Kazxd/3dof-sorter/cad/preview/adapter_bolt.png

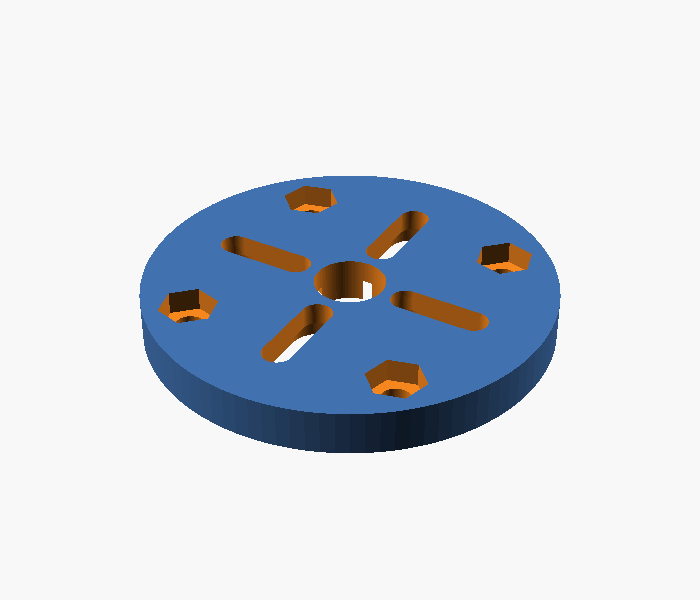
cad/preview/adapter_bolt.png
