Kazxd/3dof-sorter/cad/preview/carrier.png

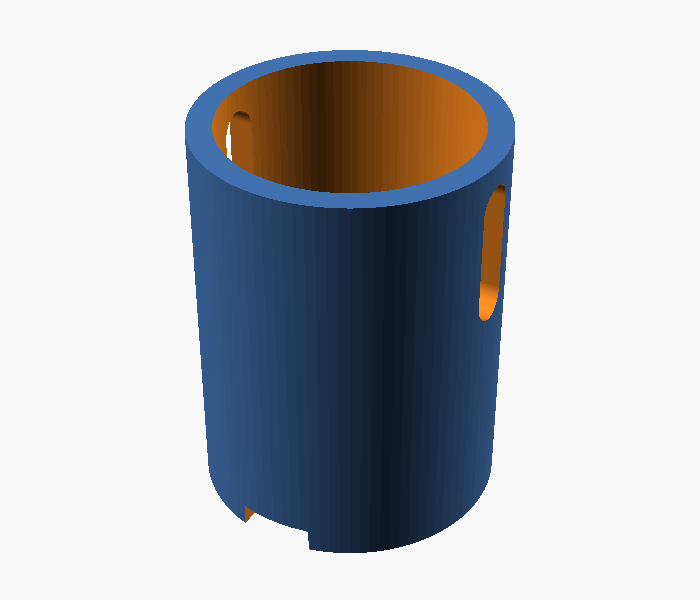
cad/preview/carrier.png
