Kazxd/3dof-sorter/cad/preview/hanger_front.png

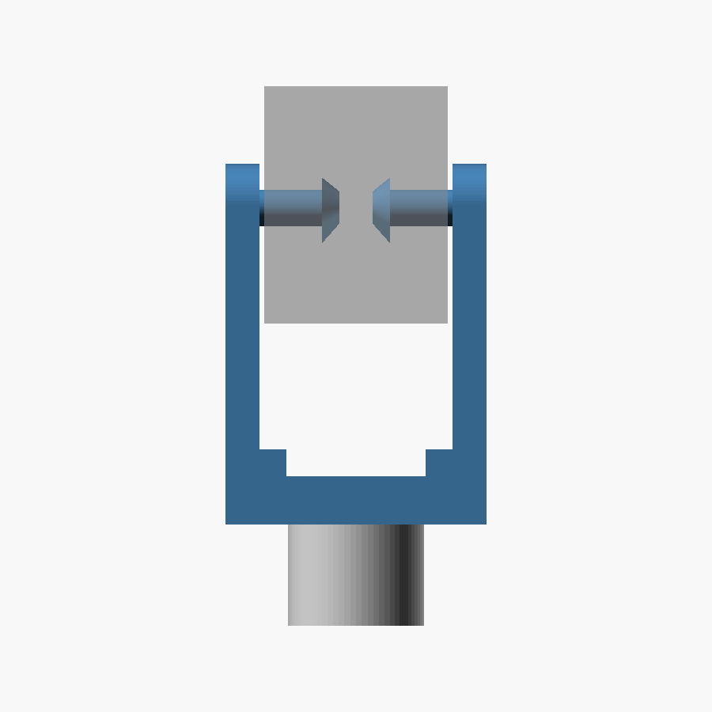
cad/preview/hanger_front.png
