Kazxd/3dof-sorter/cad/preview/rigid_cup.png

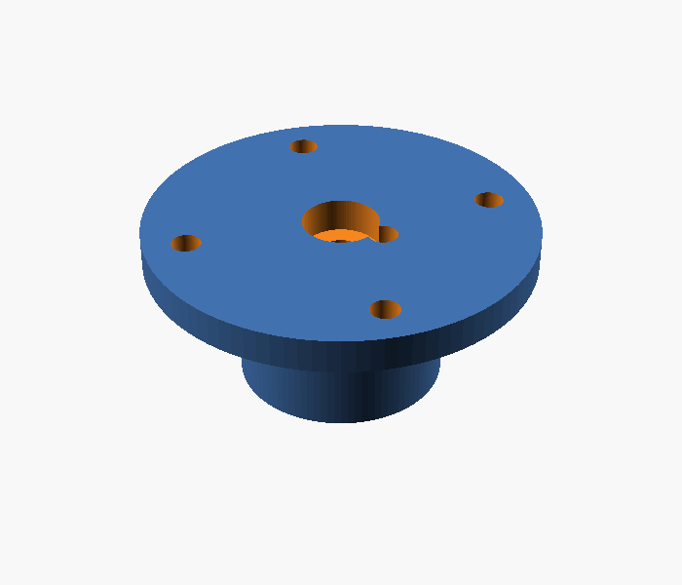
cad/preview/rigid_cup.png
