Kazxd/3dof-sorter/cad/preview/sleeve.png

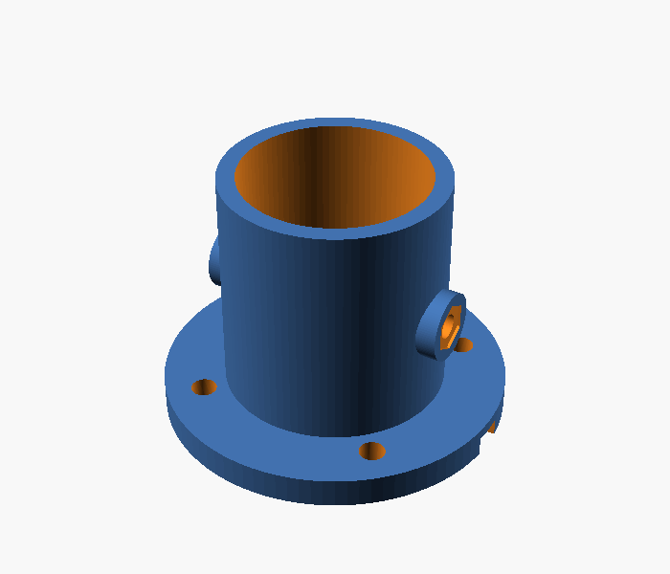
cad/preview/sleeve.png
