Kazxd/3dof-sorter/Nuts and Bolts.v1i.yolov8/valid/images/1-heavy-hex-bolt-6-set-hardware-original-imagfbzp4ufacajw_jpeg_jpg.rf.dfc6f21525f2c15a8e8666800c9e3701.jpg

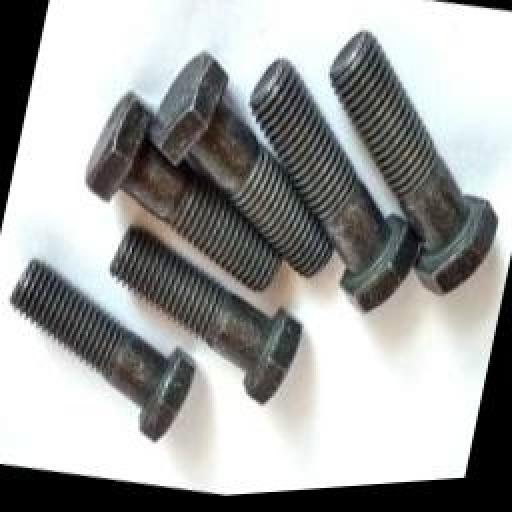
Nuts and Bolts.v1i.yolov8/valid/images/1-heavy-hex-bolt-6-set-hardware-original-imagfbzp4ufacajw_jpeg_jpg.rf.dfc6f21525f2c15a8e8666800c9e3701.jpg
