Kazxd/3dof-sorter/Nuts and Bolts.v1i.yolov8/valid/images/5inch-mild-steel-nut-bolt-500x500_jpeg_jpg.rf.86e7fe1448f5a15573644239efd2a761.jpg

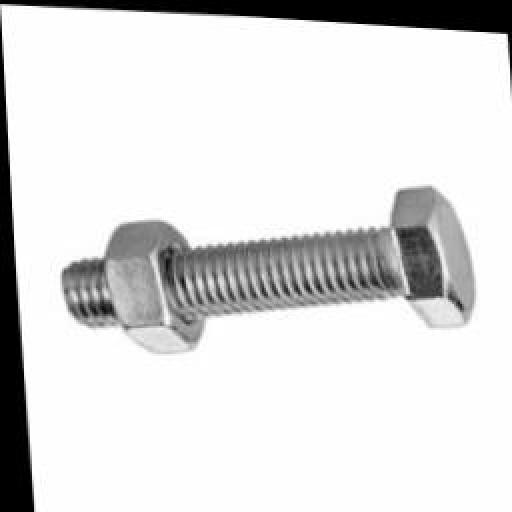
Nuts and Bolts.v1i.yolov8/valid/images/5inch-mild-steel-nut-bolt-500x500_jpeg_jpg.rf.86e7fe1448f5a15573644239efd2a761.jpg
