Kazxd/3dof-sorter/Nuts and Bolts.v1i.yolov8/valid/images/22_jpg.rf.d1f2ec3deb03ffdd9a8e1cb189490dce.jpg

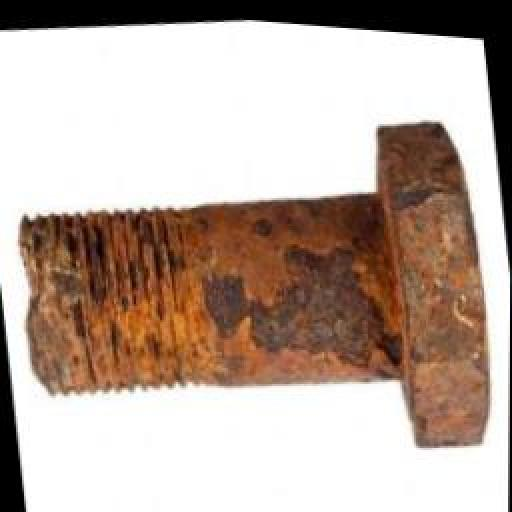
Nuts and Bolts.v1i.yolov8/valid/images/22_jpg.rf.d1f2ec3deb03ffdd9a8e1cb189490dce.jpg
