Kazxd/3dof-sorter/Nuts and Bolts.v1i.yolov8/valid/images/24_jpg.rf.6460cae588378a65f7cb0c4df6d592ca.jpg

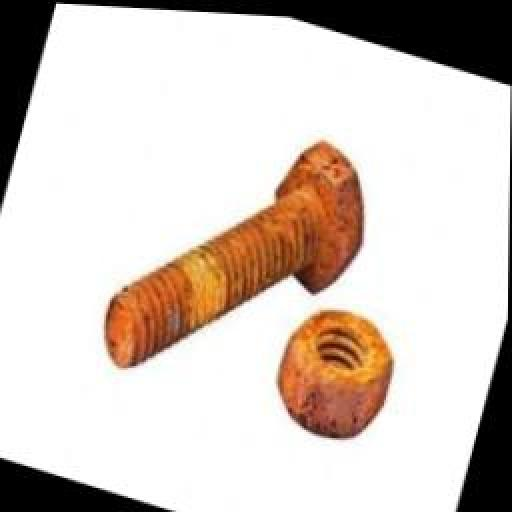
Nuts and Bolts.v1i.yolov8/valid/images/24_jpg.rf.6460cae588378a65f7cb0c4df6d592ca.jpg
