Kazxd/3dof-sorter/Nuts and Bolts.v1i.yolov8/valid/images/27_jpg.rf.afc388b61799de5133c476738ec6b074.jpg

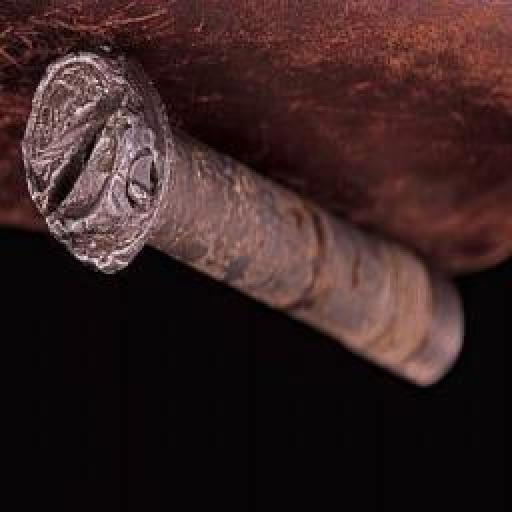
Nuts and Bolts.v1i.yolov8/valid/images/27_jpg.rf.afc388b61799de5133c476738ec6b074.jpg
