Kazxd/3dof-sorter/Nuts and Bolts.v1i.yolov8/valid/images/28_jpg.rf.2d5adec151693ffee0fa9186a34a14be.jpg

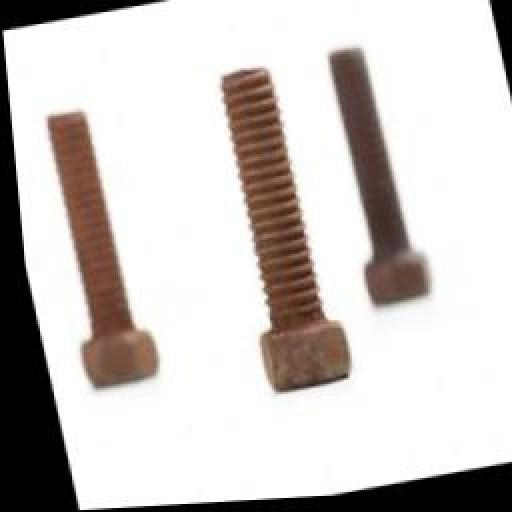
Nuts and Bolts.v1i.yolov8/valid/images/28_jpg.rf.2d5adec151693ffee0fa9186a34a14be.jpg
