Kazxd/3dof-sorter/Nuts and Bolts.v1i.yolov8/valid/images/29_jpg.rf.64ed55d56bdb5906e46a98ffbae678ac.jpg

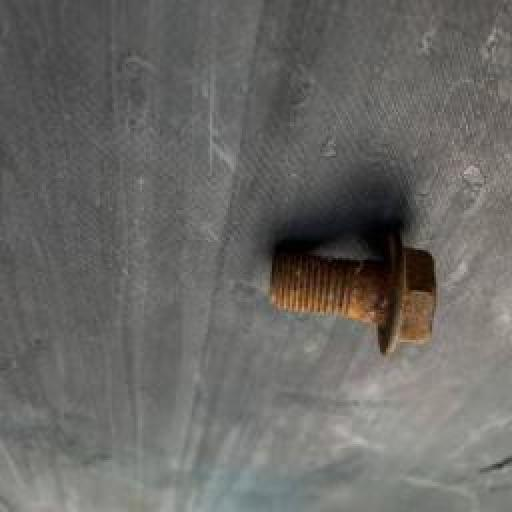
Nuts and Bolts.v1i.yolov8/valid/images/29_jpg.rf.64ed55d56bdb5906e46a98ffbae678ac.jpg
