Kazxd/3dof-sorter/Nuts and Bolts.v1i.yolov8/valid/images/30_jpg.rf.de850487259090f0898810ef57d4c8f7.jpg

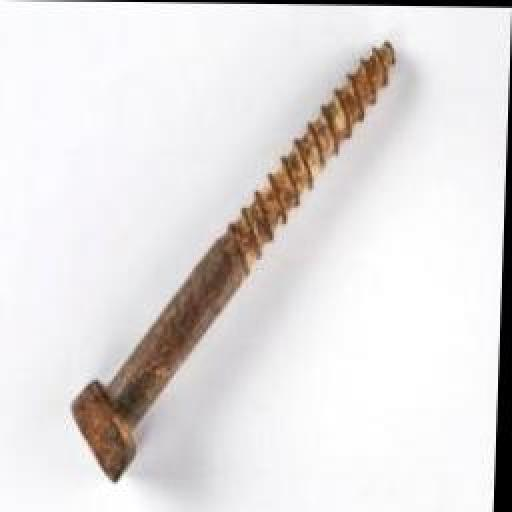
Nuts and Bolts.v1i.yolov8/valid/images/30_jpg.rf.de850487259090f0898810ef57d4c8f7.jpg
