Kazxd/3dof-sorter/Nuts and Bolts.v1i.yolov8/valid/images/30_jpg.rf.e808f95cd140b9b9f8c46c7ac13455a9.jpg

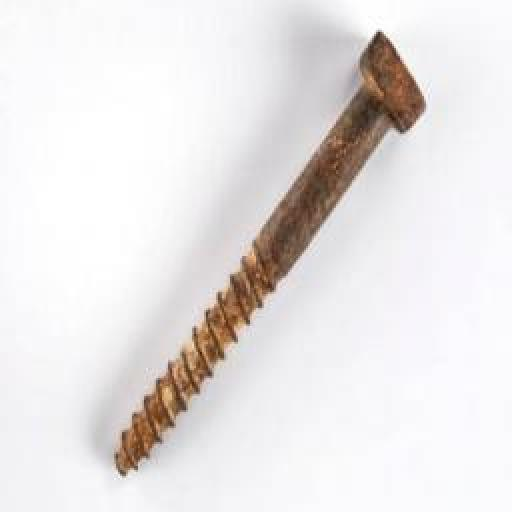
Nuts and Bolts.v1i.yolov8/valid/images/30_jpg.rf.e808f95cd140b9b9f8c46c7ac13455a9.jpg
