Kazxd/3dof-sorter/Nuts and Bolts.v1i.yolov8/valid/images/50_jpg.rf.1675c04a91fb54c2cea84c65e0de0e85.jpg

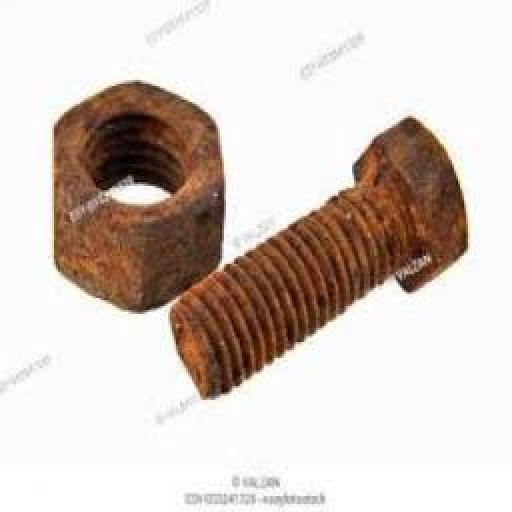
Nuts and Bolts.v1i.yolov8/valid/images/50_jpg.rf.1675c04a91fb54c2cea84c65e0de0e85.jpg
