Kazxd/3dof-sorter/Nuts and Bolts.v1i.yolov8/valid/images/53_jpg.rf.82dfdd458fb2ca40ef70635bc36b0871.jpg

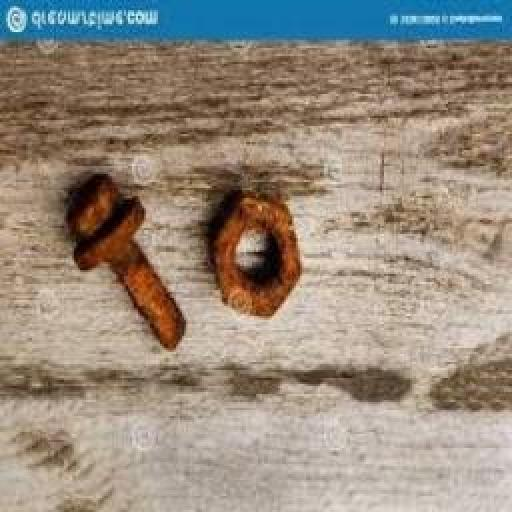
Nuts and Bolts.v1i.yolov8/valid/images/53_jpg.rf.82dfdd458fb2ca40ef70635bc36b0871.jpg
