Kazxd/3dof-sorter/Nuts and Bolts.v1i.yolov8/valid/images/360_F_650699123_XyNEPfjZqgRsTFS0PMfwW5s5IRTDETz2_jpg.rf.19e3b7fa537eb292dc3e8215b2b9476f.jpg

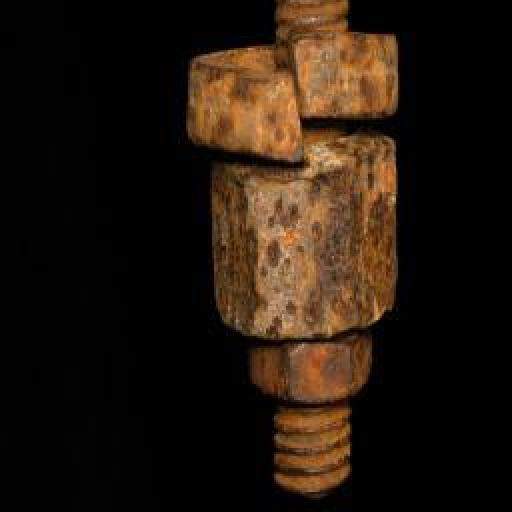
Nuts and Bolts.v1i.yolov8/valid/images/360_F_650699123_XyNEPfjZqgRsTFS0PMfwW5s5IRTDETz2_jpg.rf.19e3b7fa537eb292dc3e8215b2b9476f.jpg
