Kazxd/3dof-sorter/Nuts and Bolts.v1i.yolov8/valid/images/545f23911fa3bb2c8df4edf4684a21a9_jpg.rf.d1d3743f2dee5c5640503f124749c4a2.jpg

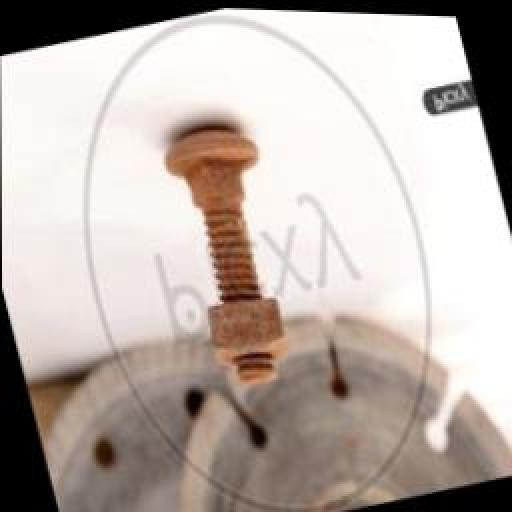
Nuts and Bolts.v1i.yolov8/valid/images/545f23911fa3bb2c8df4edf4684a21a9_jpg.rf.d1d3743f2dee5c5640503f124749c4a2.jpg
