Kazxd/3dof-sorter/Nuts and Bolts.v1i.yolov8/valid/images/6491-a-bolt-and-nut-isolated-on-a-white-background-pv_jpg.rf.5d7b3faf881b47f7fb27427807b29e08.jpg

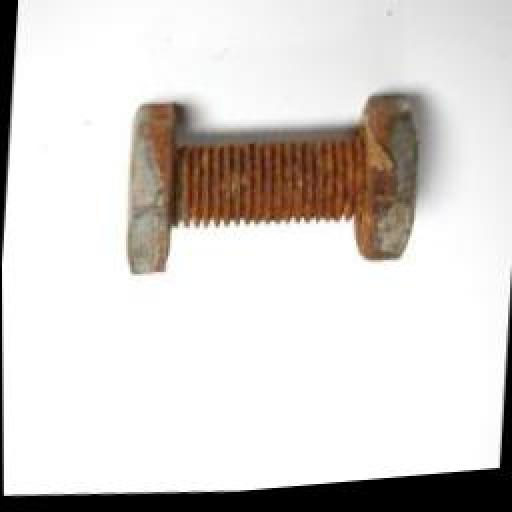
Nuts and Bolts.v1i.yolov8/valid/images/6491-a-bolt-and-nut-isolated-on-a-white-background-pv_jpg.rf.5d7b3faf881b47f7fb27427807b29e08.jpg
