Kazxd/3dof-sorter/Nuts and Bolts.v1i.yolov8/valid/images/9703160-rusty-screws-and-bolts-isolated-on-white_jpg.rf.10e5fe2db2fa7fae86ca0d51dbcad605.jpg

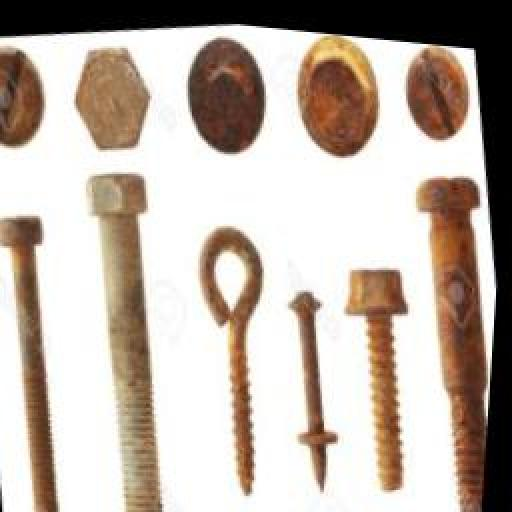
Nuts and Bolts.v1i.yolov8/valid/images/9703160-rusty-screws-and-bolts-isolated-on-white_jpg.rf.10e5fe2db2fa7fae86ca0d51dbcad605.jpg
