Kazxd/3dof-sorter/Nuts and Bolts.v1i.yolov8/valid/images/409269715_jpg.rf.56d3913b8d70f14f4a9e99a2cb2239ff.jpg

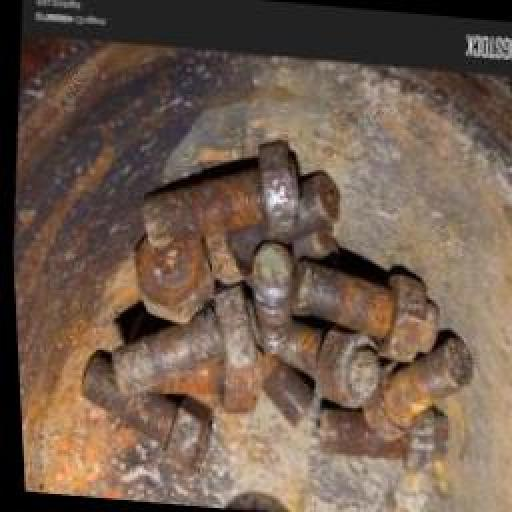
Nuts and Bolts.v1i.yolov8/valid/images/409269715_jpg.rf.56d3913b8d70f14f4a9e99a2cb2239ff.jpg
