Kazxd/3dof-sorter/Nuts and Bolts.v1i.yolov8/valid/images/-been-snipped-or-broken-from-its-head-isolated-on-a-white-background-2PN02R0_jpg.rf.fc58b6a8a093d53d864c8f45f3969fa1.jpg

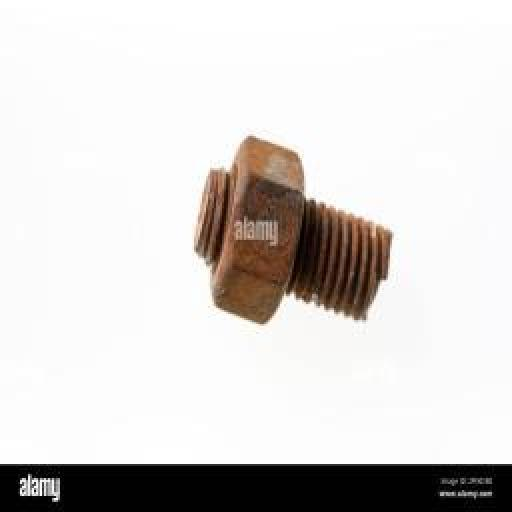
Nuts and Bolts.v1i.yolov8/valid/images/-been-snipped-or-broken-from-its-head-isolated-on-a-white-background-2PN02R0_jpg.rf.fc58b6a8a093d53d864c8f45f3969fa1.jpg
