Kazxd/3dof-sorter/Nuts and Bolts.v1i.yolov8/valid/images/ent-white-background-heavy-metal-bolt-nuts-washers-tools-equipment-144955972_jpg.rf.b583a54da3a61eebf552d2887a8948e6.jpg

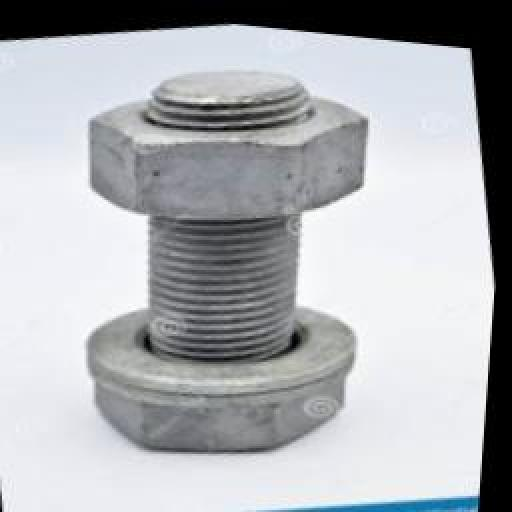
Nuts and Bolts.v1i.yolov8/valid/images/ent-white-background-heavy-metal-bolt-nuts-washers-tools-equipment-144955972_jpg.rf.b583a54da3a61eebf552d2887a8948e6.jpg
