Kazxd/3dof-sorter/Nuts and Bolts.v1i.yolov8/valid/images/FIB1R56IDIN7K44_jpg.rf.6c4e473989d37a4cc9a64add21283fd1.jpg

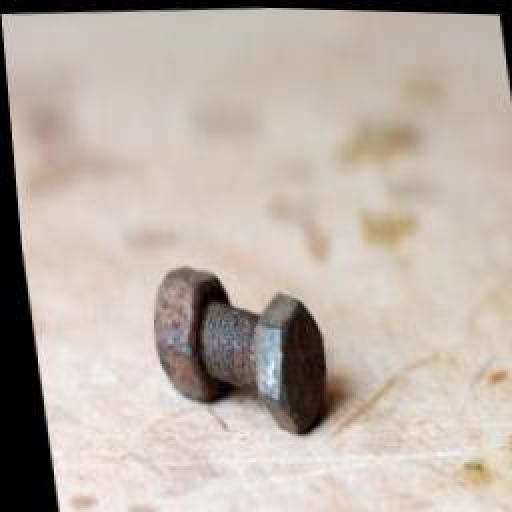
Nuts and Bolts.v1i.yolov8/valid/images/FIB1R56IDIN7K44_jpg.rf.6c4e473989d37a4cc9a64add21283fd1.jpg
