Kazxd/3dof-sorter/Nuts and Bolts.v1i.yolov8/valid/images/image_116_png_jpg.rf.806f9b7ccc918074ac511350cd38e6d4.jpg

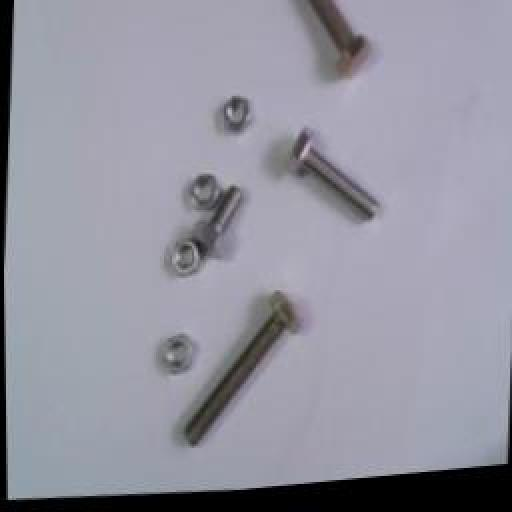
Nuts and Bolts.v1i.yolov8/valid/images/image_116_png_jpg.rf.806f9b7ccc918074ac511350cd38e6d4.jpg
