Kazxd/3dof-sorter/Nuts and Bolts.v1i.yolov8/valid/images/image_124_png_jpg.rf.222f5cac51b2965d7b71004286ff9e4e.jpg

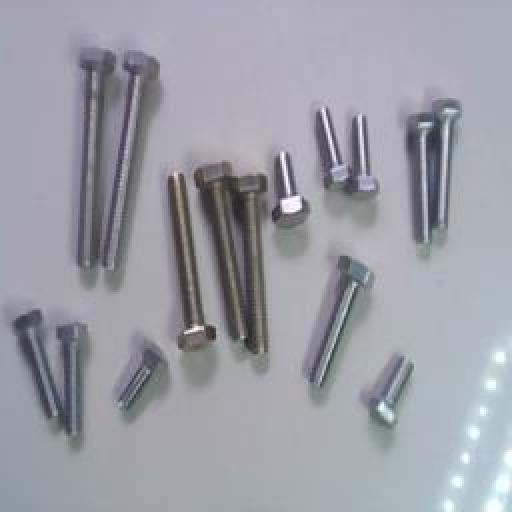
Nuts and Bolts.v1i.yolov8/valid/images/image_124_png_jpg.rf.222f5cac51b2965d7b71004286ff9e4e.jpg
