Kazxd/3dof-sorter/Nuts and Bolts.v1i.yolov8/valid/images/image_127_png_jpg.rf.f189bd708a3b0e386e8cdf17f5f00c28.jpg

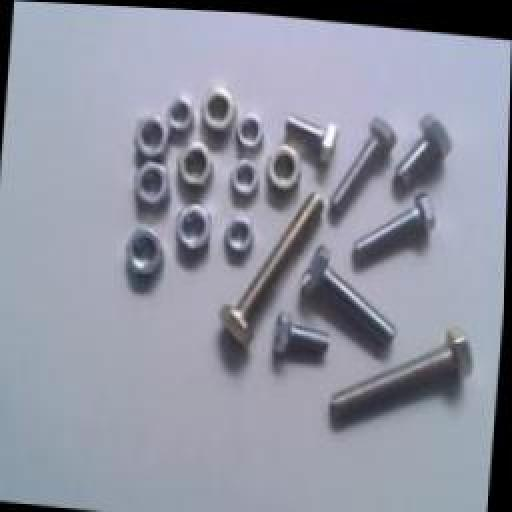
Nuts and Bolts.v1i.yolov8/valid/images/image_127_png_jpg.rf.f189bd708a3b0e386e8cdf17f5f00c28.jpg
