Kazxd/3dof-sorter/Nuts and Bolts.v1i.yolov8/valid/images/image_140_png_jpg.rf.bd3fe15dc6e5364fa3a23be50c95cafd.jpg

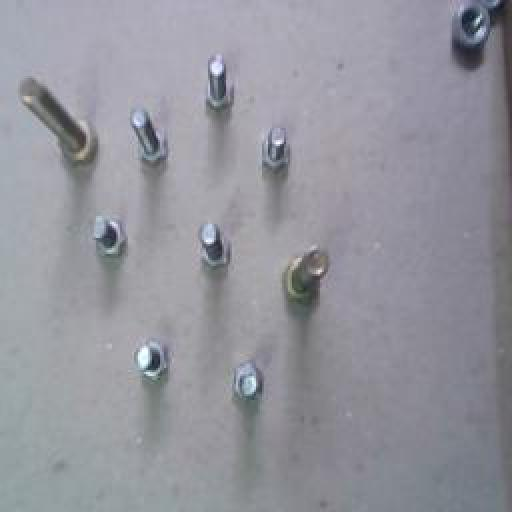
Nuts and Bolts.v1i.yolov8/valid/images/image_140_png_jpg.rf.bd3fe15dc6e5364fa3a23be50c95cafd.jpg
