Kazxd/3dof-sorter/Nuts and Bolts.v1i.yolov8/valid/images/image_160_png_jpg.rf.7491435820400c92e7f343dc29fcd595.jpg

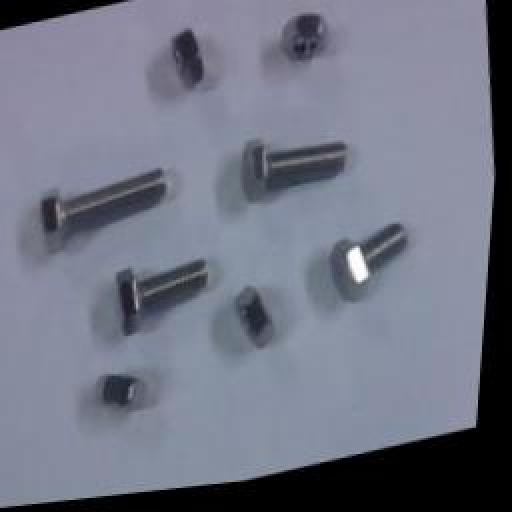
Nuts and Bolts.v1i.yolov8/valid/images/image_160_png_jpg.rf.7491435820400c92e7f343dc29fcd595.jpg
