Kazxd/3dof-sorter/Nuts and Bolts.v1i.yolov8/valid/images/image_160_png_jpg.rf.e400411dc05c77701b53554323aa39fd.jpg

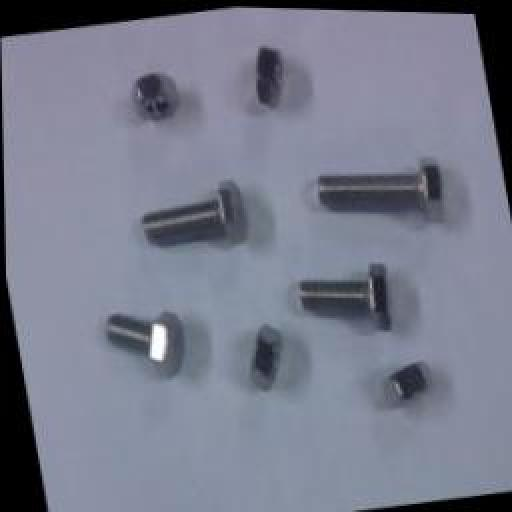
Nuts and Bolts.v1i.yolov8/valid/images/image_160_png_jpg.rf.e400411dc05c77701b53554323aa39fd.jpg
