Kazxd/3dof-sorter/Nuts and Bolts.v1i.yolov8/valid/images/images10_jpg.rf.aa0c122afe898b3eaac940de06f8ee19.jpg

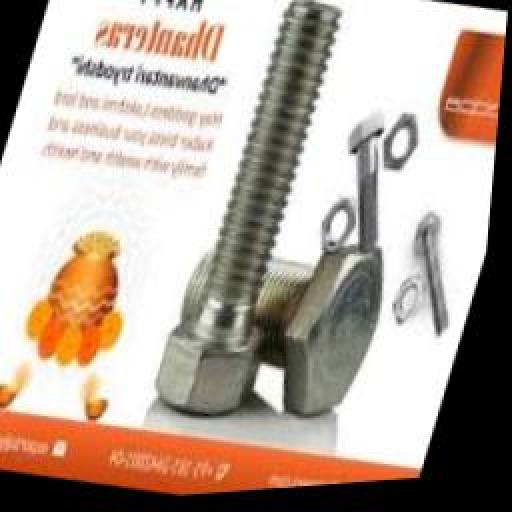
Nuts and Bolts.v1i.yolov8/valid/images/images10_jpg.rf.aa0c122afe898b3eaac940de06f8ee19.jpg
