Kazxd/3dof-sorter/Nuts and Bolts.v1i.yolov8/valid/images/images102_jpg.rf.8625699c36f615650583026785455182.jpg

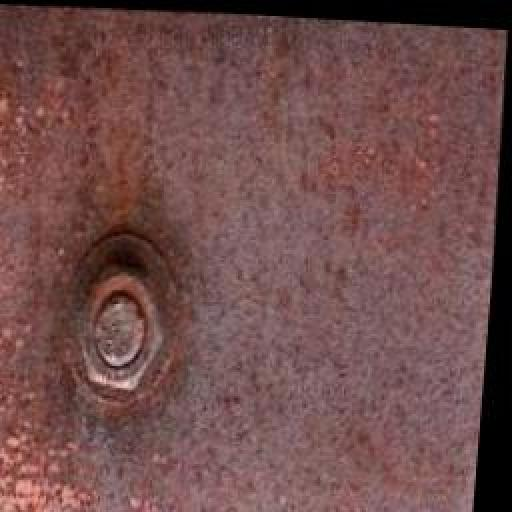
Nuts and Bolts.v1i.yolov8/valid/images/images102_jpg.rf.8625699c36f615650583026785455182.jpg
