Kazxd/3dof-sorter/Nuts and Bolts.v1i.yolov8/valid/images/images130_jpg.rf.2f850fdbcc7ca3f3bb6750351661165f.jpg

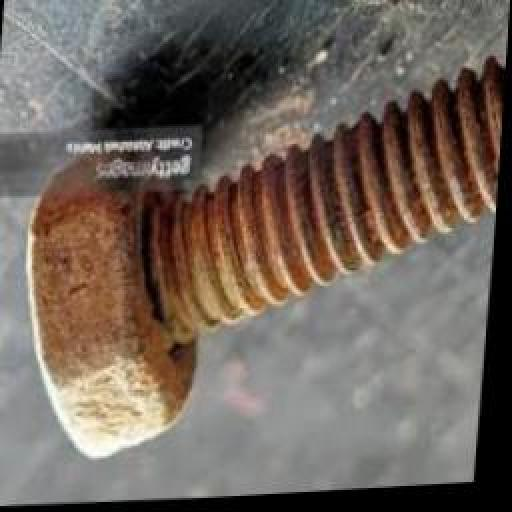
Nuts and Bolts.v1i.yolov8/valid/images/images130_jpg.rf.2f850fdbcc7ca3f3bb6750351661165f.jpg
