Kazxd/3dof-sorter/Nuts and Bolts.v1i.yolov8/valid/images/images133_jpg.rf.38856a5a66fccfa05bb6818912eb8c8f.jpg

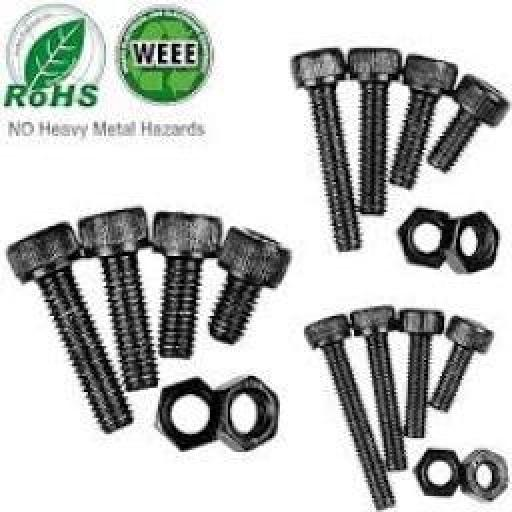
Nuts and Bolts.v1i.yolov8/valid/images/images133_jpg.rf.38856a5a66fccfa05bb6818912eb8c8f.jpg
