Kazxd/3dof-sorter/Nuts and Bolts.v1i.yolov8/valid/images/rusty-bolt-and-nuts-2C5777T_jpg.rf.48c1cb1803eae311d1a35a7afa7476f2.jpg

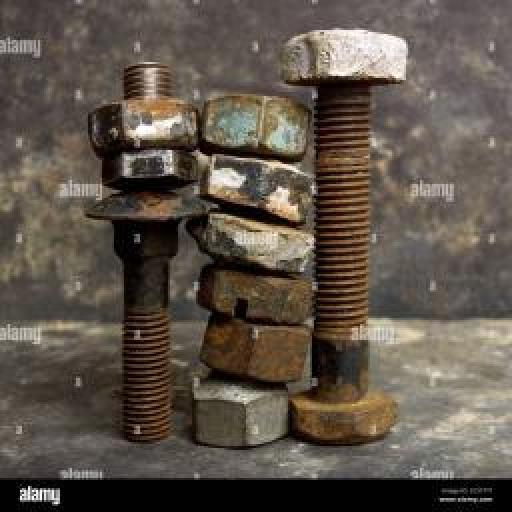
Nuts and Bolts.v1i.yolov8/valid/images/rusty-bolt-and-nuts-2C5777T_jpg.rf.48c1cb1803eae311d1a35a7afa7476f2.jpg
