Kazxd/3dof-sorter/Nuts and Bolts.v1i.yolov8/valid/images/rusty-bolt-royalty-free-image-1636050220_jpg.rf.3dac28fb71df53db622fbdd1d7d432d8.jpg

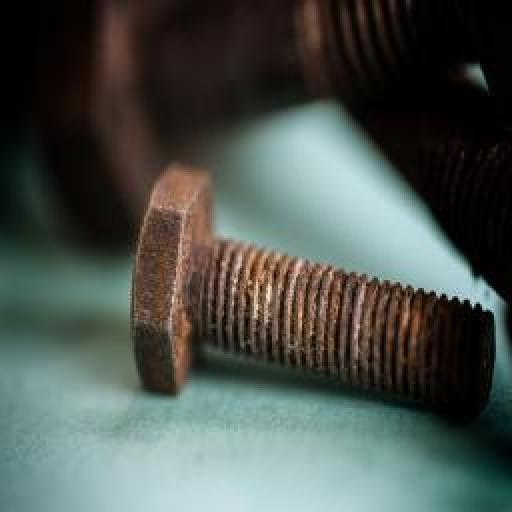
Nuts and Bolts.v1i.yolov8/valid/images/rusty-bolt-royalty-free-image-1636050220_jpg.rf.3dac28fb71df53db622fbdd1d7d432d8.jpg
