Kazxd/3dof-sorter/Nuts and Bolts.v1i.yolov8/valid/images/rusty-bolts-with-nuts-white-background_525574-5550_jpg.rf.06d85822295db872927e3f74d5d160ce.jpg

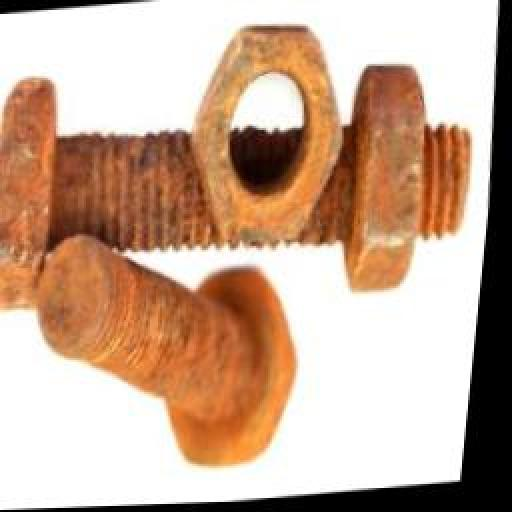
Nuts and Bolts.v1i.yolov8/valid/images/rusty-bolts-with-nuts-white-background_525574-5550_jpg.rf.06d85822295db872927e3f74d5d160ce.jpg
