Kazxd/3dof-sorter/Nuts and Bolts.v1i.yolov8/valid/images/rusty-bolts_jpg.rf.68e16ab453f6119d23ae1e8f16882ad3.jpg

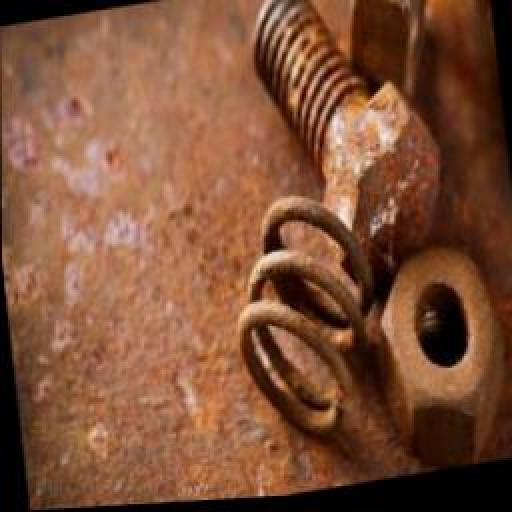
Nuts and Bolts.v1i.yolov8/valid/images/rusty-bolts_jpg.rf.68e16ab453f6119d23ae1e8f16882ad3.jpg
