Kazxd/3dof-sorter/Nuts and Bolts.v1i.yolov8/valid/images/rusty-nut-bolt-isolated-on-260nw-70090501_jpg.rf.6edbee4fa5cebb4eb70144c56de7757c.jpg

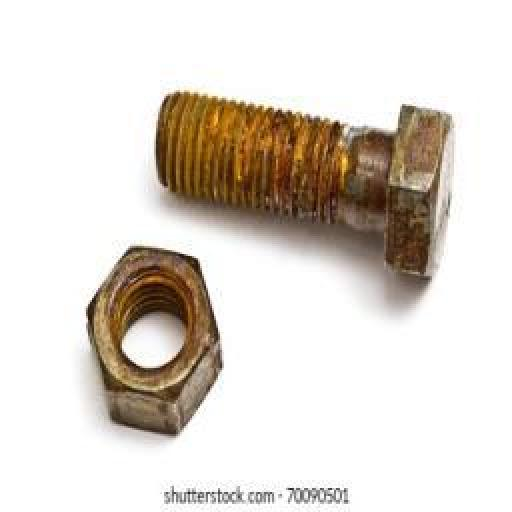
Nuts and Bolts.v1i.yolov8/valid/images/rusty-nut-bolt-isolated-on-260nw-70090501_jpg.rf.6edbee4fa5cebb4eb70144c56de7757c.jpg
