Kazxd/3dof-sorter/Nuts and Bolts.v1i.yolov8/valid/images/rusty-nut-bolt-isolated-white-28397746_jpg.rf.41d1f0284ed0980c21c48107f2b0d2d7.jpg

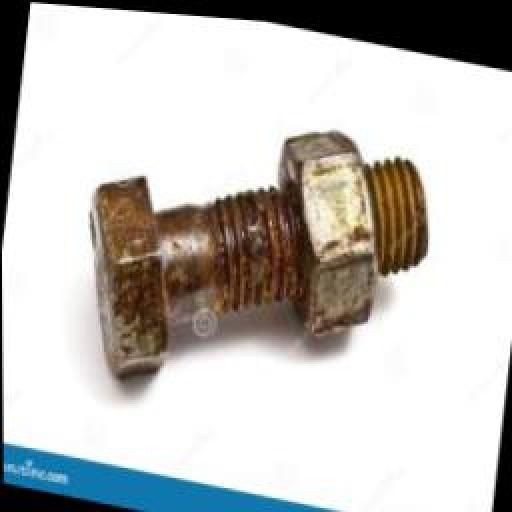
Nuts and Bolts.v1i.yolov8/valid/images/rusty-nut-bolt-isolated-white-28397746_jpg.rf.41d1f0284ed0980c21c48107f2b0d2d7.jpg
