Kazxd/3dof-sorter/Nuts and Bolts.v1i.yolov8/valid/images/screwed-royalty-free-image-1638481300_jpg.rf.7db511b03831097691b17ad6a8ffaa8f.jpg

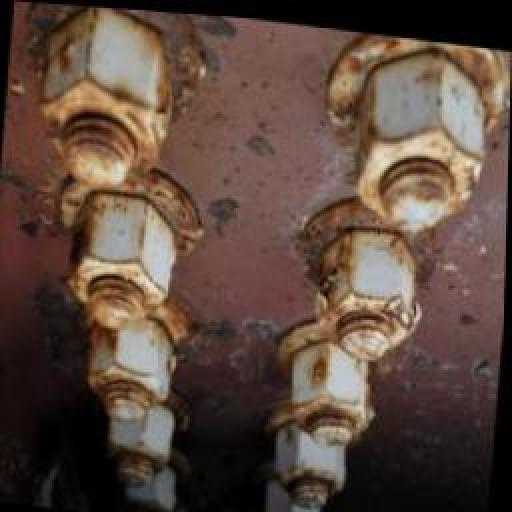
Nuts and Bolts.v1i.yolov8/valid/images/screwed-royalty-free-image-1638481300_jpg.rf.7db511b03831097691b17ad6a8ffaa8f.jpg
