Kazxd/3dof-sorter/Nuts and Bolts.v1i.yolov8/valid/images/screws_034_png_jpg.rf.e1b1466a737b8fe22fa448a830b26b05.jpg

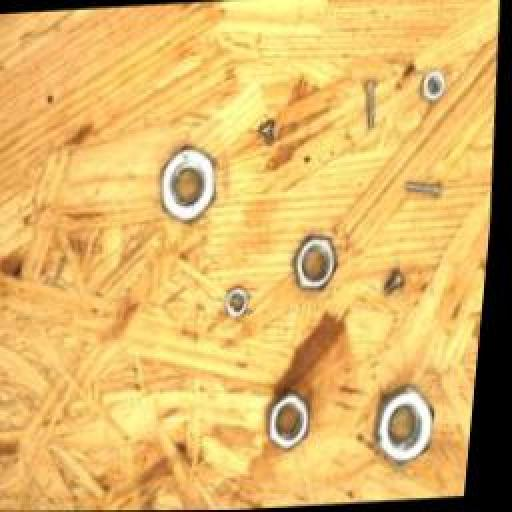
Nuts and Bolts.v1i.yolov8/valid/images/screws_034_png_jpg.rf.e1b1466a737b8fe22fa448a830b26b05.jpg
