Kazxd/3dof-sorter/Nuts and Bolts.v1i.yolov8/valid/images/steel-bolt-hex-nut-washer-260nw-2484265203_jpg.rf.426e1dbc908650547e6eae5a579fb2f9.jpg

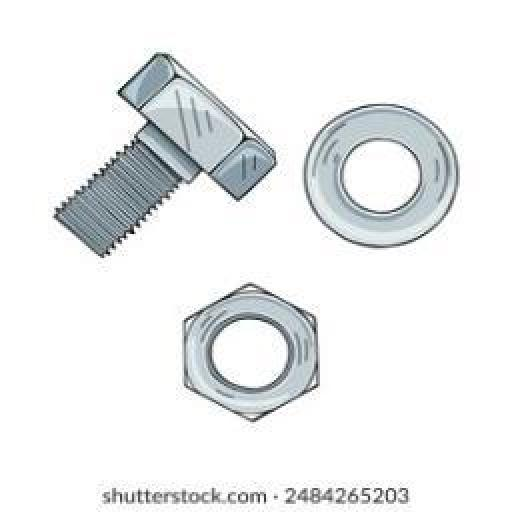
Nuts and Bolts.v1i.yolov8/valid/images/steel-bolt-hex-nut-washer-260nw-2484265203_jpg.rf.426e1dbc908650547e6eae5a579fb2f9.jpg
