Kazxd/3dof-sorter/Nuts and Bolts.v1i.yolov8/valid/images/thumb-16-_jpg.rf.abbc0b00ce17790db569c43730c551b1.jpg

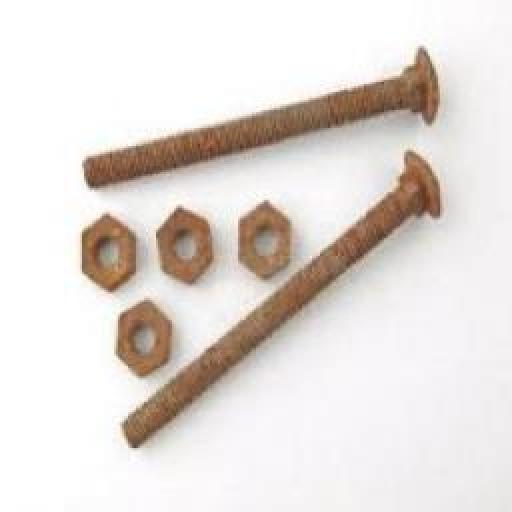
Nuts and Bolts.v1i.yolov8/valid/images/thumb-16-_jpg.rf.abbc0b00ce17790db569c43730c551b1.jpg
