Kazxd/3dof-sorter/Nuts and Bolts.v1i.yolov8/valid/images/thumb-33-_jpg.rf.a28ae6f798aafaa6da089a47b7dafef5.jpg

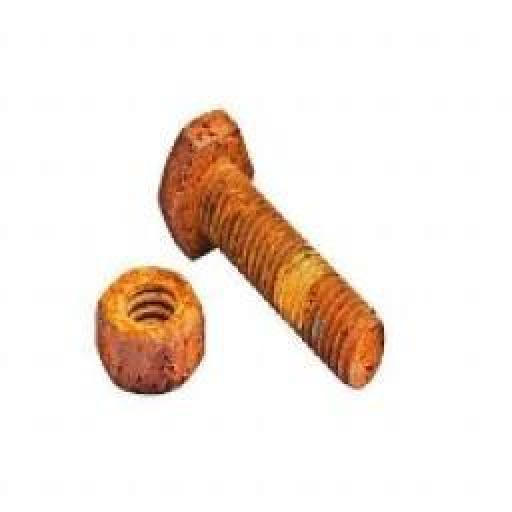
Nuts and Bolts.v1i.yolov8/valid/images/thumb-33-_jpg.rf.a28ae6f798aafaa6da089a47b7dafef5.jpg
