Kazxd/3dof-sorter/Nuts and Bolts.v1i.yolov8/valid/images/thumb-43-_jpg.rf.0d8759c0bf81b6b5e54e2ecef139d906.jpg

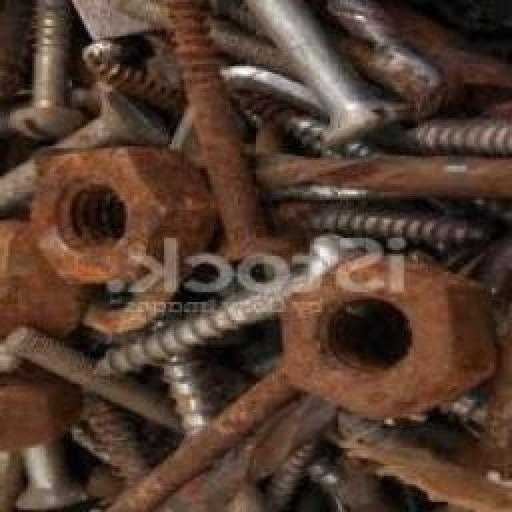
Nuts and Bolts.v1i.yolov8/valid/images/thumb-43-_jpg.rf.0d8759c0bf81b6b5e54e2ecef139d906.jpg
