Kazxd/3dof-sorter/Nuts and Bolts.v1i.yolov8/valid/images/thumb-45-_jpg.rf.ce1f24acde7183acbda3fc9f8d2d387d.jpg

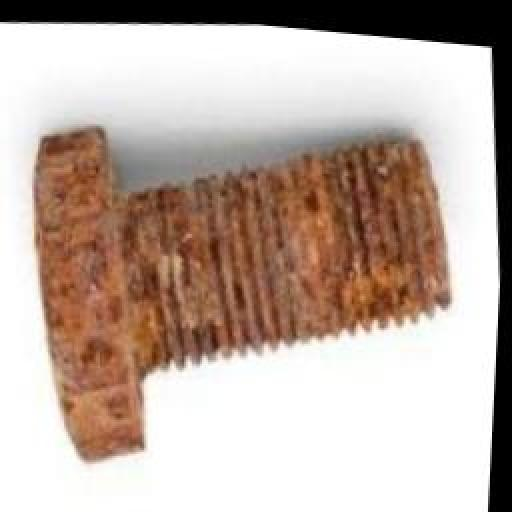
Nuts and Bolts.v1i.yolov8/valid/images/thumb-45-_jpg.rf.ce1f24acde7183acbda3fc9f8d2d387d.jpg
