Kazxd/3dof-sorter/Nuts and Bolts.v1i.yolov8/valid/images/thumb-46-_jpg.rf.b82bc75c01313968185569fc0239f79b.jpg

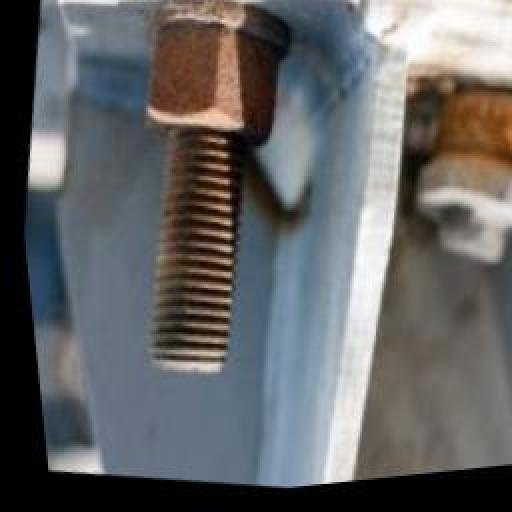
Nuts and Bolts.v1i.yolov8/valid/images/thumb-46-_jpg.rf.b82bc75c01313968185569fc0239f79b.jpg
