Kazxd/3dof-sorter/Nuts and Bolts.v1i.yolov8/valid/images/tvs-bolts-500x500_jpg.rf.d076b9053ce634e65f1fc6d05ca51b9c.jpg

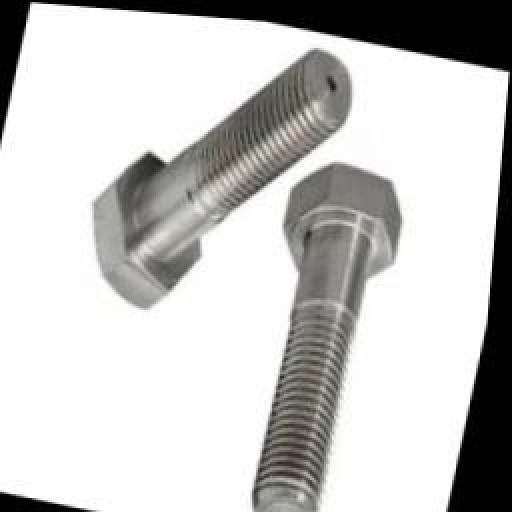
Nuts and Bolts.v1i.yolov8/valid/images/tvs-bolts-500x500_jpg.rf.d076b9053ce634e65f1fc6d05ca51b9c.jpg
