Kazxd/3dof-sorter/Nuts and Bolts.v1i.yolov8/valid/images/white-background-closeup-rusty-nuts-bolts-white-background-closeup-105165246_jpg.rf.6880e69673c644f6f0d9fc2275443cf6.jpg

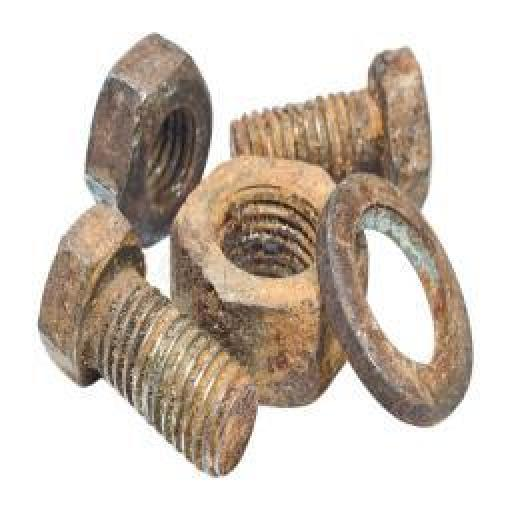
Nuts and Bolts.v1i.yolov8/valid/images/white-background-closeup-rusty-nuts-bolts-white-background-closeup-105165246_jpg.rf.6880e69673c644f6f0d9fc2275443cf6.jpg
