Kazxd/3dof-sorter/cad/stl/magnet_hanger_petg.stl

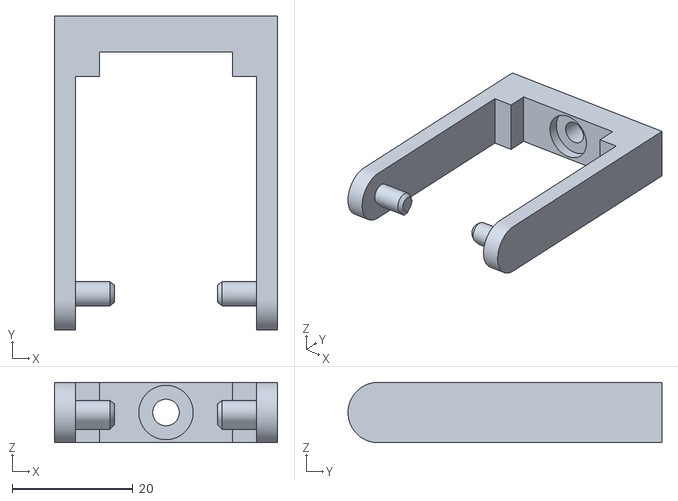
[picture p52: CAD file, 2026-10-26]
cad/stl/magnet_hanger_petg.stl
37.0 x 52.0 x 10.0
