Kazxd/3dof-sorter/cad/stl/magnet_hanger_pla_petg.stl

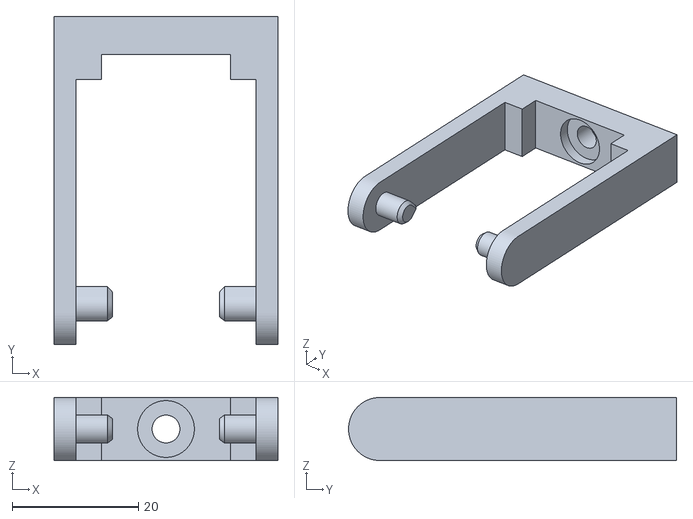
[picture p53: CAD file, 2026-10-26]
cad/stl/magnet_hanger_pla_petg.stl
35.5 x 52.0 x 10.0
