Kazxd/3dof-sorter/cad/stl/magnet_hanger.stl

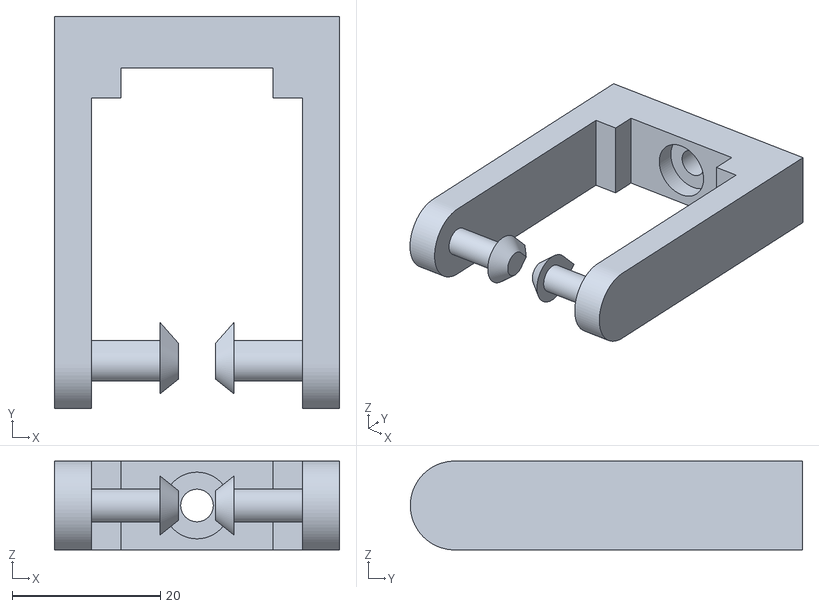
[picture p54: CAD file, 2026-10-26]
cad/stl/magnet_hanger.stl
38.5 x 53.0 x 12.0
