Kazxd/3dof-sorter/cad/stl/magnet_peg_test.stl

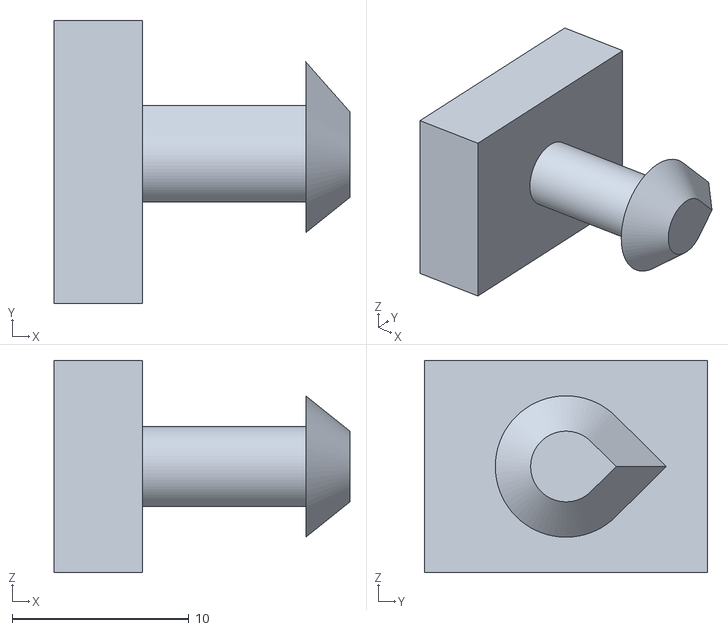
[picture p55: CAD file, 2026-10-26]
cad/stl/magnet_peg_test.stl
16.8 x 16.0 x 12.0
