Kazxd/3dof-sorter/cad/stl/rigid_cup.stl

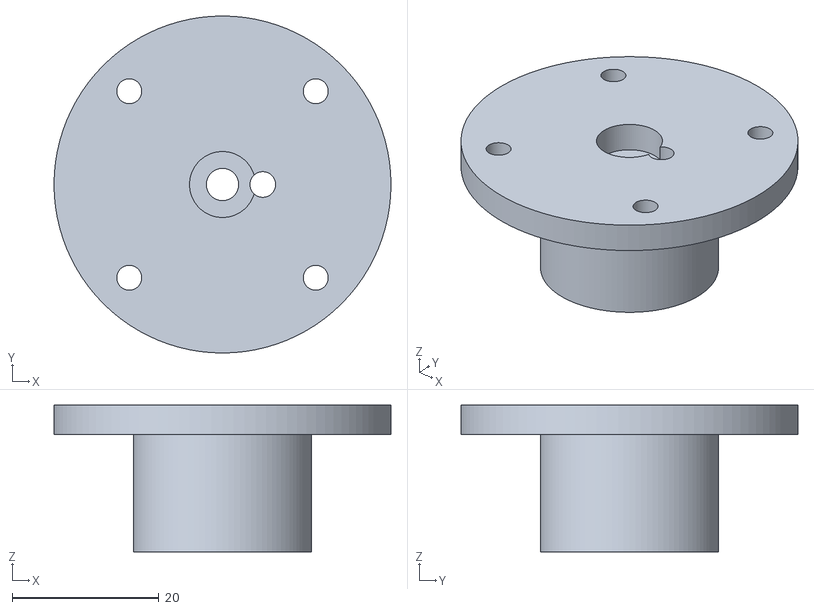
[picture p56: CAD file, 2026-10-20]
cad/stl/rigid_cup.stl
46.0 x 46.0 x 20.0
