Kazxd/3dof-sorter/cad/stl/adapter_horn.stl

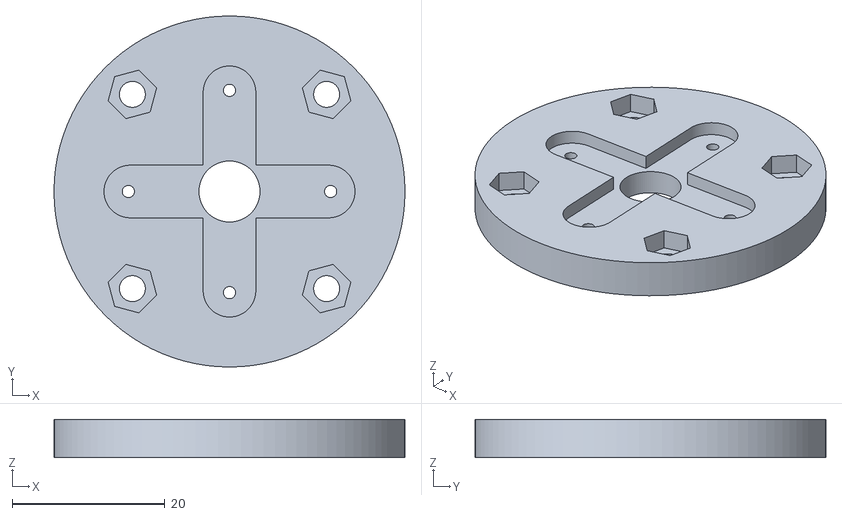
[picture p57: CAD file, 2026-10-20]
cad/stl/adapter_horn.stl
46.0 x 46.0 x 5.00
