Kazxd/3dof-sorter/cad/stl/sleeve.stl

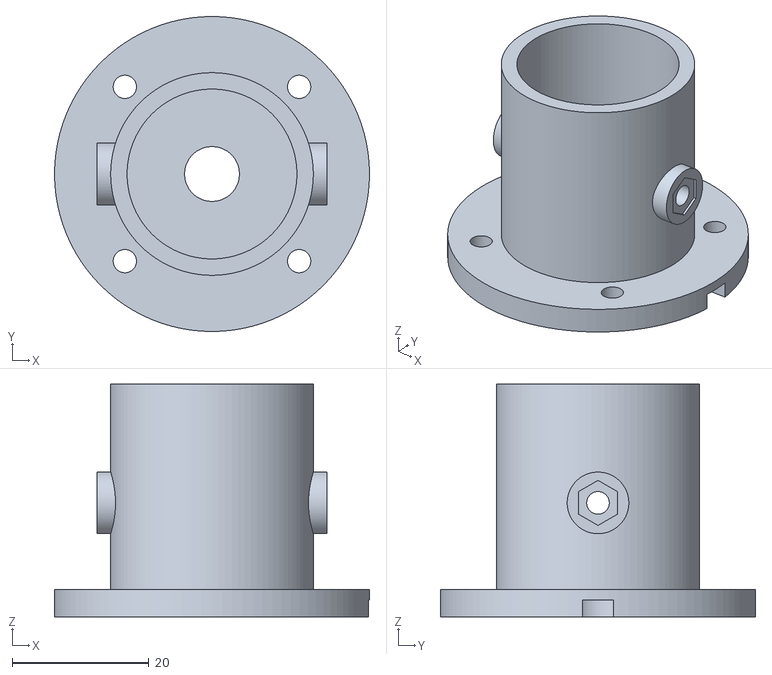
[picture p58: CAD file, 2026-10-20]
cad/stl/sleeve.stl
46.0 x 46.0 x 34.0
