Kazxd/3dof-sorter/cad/stl/carrier.stl

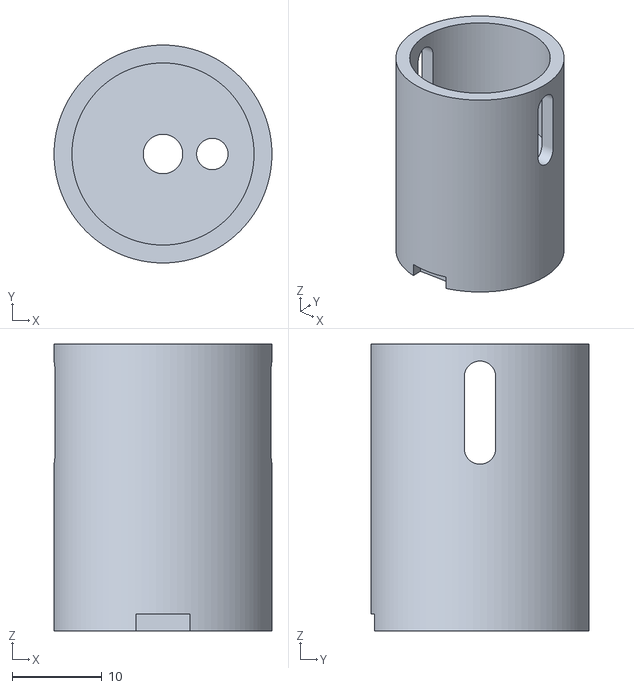
[picture p59: CAD file, 2026-10-20]
cad/stl/carrier.stl
24.3 x 24.3 x 32.0
