Kazxd/3dof-sorter/cad/stl/adapter_bolt.stl

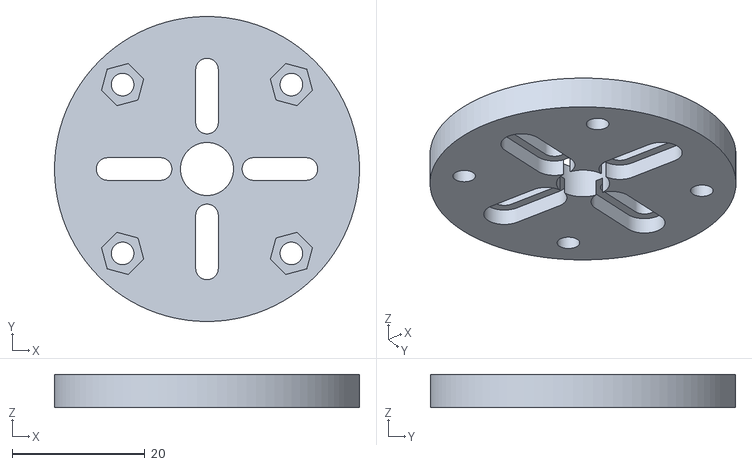
[picture p60: CAD file, 2026-10-20]
cad/stl/adapter_bolt.stl
46.0 x 46.0 x 5.00
