Kazxd/3dof-sorter/cad/magnet_hanger.scad

// magnet_hanger.scad - free-swinging hanger for the KK-P20/15 electromagnet
// =============================================================================
// The arm has no wrist servo, so a magnet bolted to the forearm tilts with it.
// This U-shaped hanger hooks into two Ø6 mm holes drilled across the forearm end
// and swings freely, so gravity keeps the magnet face pointing straight down.
//
//          side view of forearm end              front view (looking along the arm)
//      ______________________                    hook ->|  |<- hook (pegs point inward)
//     |                      |  35               |  |=======|  |
//     |            (o)<-hole |  tall             |  |  arm  |  |   arm end 27 wide
//     |____________^_________|                   |  |=======|  |
//                  17.5 from front, 17.5 up      |  |       |  |
//                                                |  |_______|  |  <- hanger, swings
//                                                |_____[o]_____|  <- screw into magnet
//                                                    [magnet]
//
// Print: TPU (95A), lying flat exactly as exported (no supports). 0.2 mm layers,
// 3 walls, 40 % infill, slow (20-25 mm/s), retraction off or very short.
// Pegs use a teardrop profile so they print without support; the hanger hangs on
// the round top of the peg, so the point never touches the hole.
//
// Fit: TPU is flexible, so just pull one arm outward, push its peg into the hole until
// the barb pops through the wall into the hollow, then do the other side. The barb is
// solid and oversized: TPU squeezes through the hole and springs back open inside.

part = "hanger";      // hanger | peg_test | assembly
style = "tpu";        // tpu = barbed snap pegs | rigid = PLA/PETG, short plain pegs, no barbs
$fn = 72;

// ---- forearm end (measured, ±1-2 mm) -------------------------------------------
arm_width   = 27.0;   // across the arm, side face to side face        [measured]
wall        = 8.0;    // side-wall thickness before the hollow inside  [measured ~7, +1 margin]
hole_d      = 6.0;    // drill size                                    [measured]
pivot_up    = 17.5;   // hole centre above the arm's bottom edge       [measured]
pivot_back  = 17.5;   // hole centre back from the arm's front edge    [measured]

// ---- magnet -------------------------------------------------------------------------
mag_d       = 20.0;
mag_h       = 15.0;
screw_d     = 4.4;    // passes M3 (use a washer) and M4
screw_len   = 10.0;   // the screw you have, total length under the head
screw_floor = 4.0;    // plastic left under the screw head (rest of the bar is recessed)
head_recess_d = 9.0;  // room for the screw head + a small washer

// ---- hanger ------------------------------------------------------------------------
side_gap    = 1.5;    // clearance each side: 30 mm between the arms for a 27 mm forearm (±1-2 mm measured)
drop        = 40.0;   // pivot centre -> top of the bottom bar (swing clearance, >= 35)
bar_t       = style == "tpu" ? 7.0 : 6.0;   // bottom bar thickness
arm_t       = style == "tpu" ? 5.0 : 3.5;   // TPU thicker to sway less; PLA/PETG thinner to bend for fitting
depth       = style == "tpu" ? 12.0 : 10.0; // hanger thickness along the forearm
top_above   = 6.0;    // hanger arm continues this far above the pivot

peg_d       = 4.0;            // spins freely in a melted Ø6 hole 
peg_play    = 0.5;            // axial play so it swings without binding
barb_len    = style == "tpu" ? 2.5 : 0;    // rigid: no barb, the stiff arms keep the pegs in
barb_d      = hole_d + 2.0;   // 8 mm: TPU squeezes through Ø6 and springs open behind the wall
barb_tip_d  = 4.0;            // pointed tip so it starts into the hole easily
split_w     = 0;              // no split: TPU flexes enough, and a solid barb holds better
split_len   = barb_len + 3.0;

inner = arm_width + 2 * side_gap;                 // gap between the two hanger arms
outer = inner + 2 * arm_t;
peg_engage = 5.0;                                 // rigid: how far a plain peg goes into the ~7 mm wall
shaft_len = style == "tpu" ? side_gap + wall + peg_play   // TPU: through the wall to the barb
                            : side_gap + peg_engage;     // rigid: part way into the hole

// 2D teardrop pointing toward -Y (print bed after the export rotation)
module teardrop(d) {
  r = d / 2;
  hull() {
    circle(r = r);
    translate([0, -r * sqrt(2)]) rotate(45) square(0.01, center = true);
  }
}

// One peg: shaft + barb, built along +X from the origin.
module peg() {
  rotate([0, 90, 0]) {   // teardrop point -> along the arm (-Y), i.e. down to the bed when printed
    if (barb_len > 0) {
      linear_extrude(shaft_len) teardrop(peg_d);
      translate([0, 0, shaft_len])
        linear_extrude(barb_len, scale = barb_tip_d / barb_d) teardrop(barb_d);
    } else {                                     // plain peg with a 0.8 mm lead-in chamfer
      linear_extrude(shaft_len - 0.8) teardrop(peg_d);
      translate([0, 0, shaft_len - 0.8])
        linear_extrude(0.8, scale = (peg_d - 1.2) / peg_d) teardrop(peg_d);
    }
  }
}

module peg_with_split() {
  if (split_w <= 0) peg(); else difference() {
    peg();
    // vertical slot (in print orientation) through the barb end
    translate([shaft_len + barb_len - split_len, -split_w / 2, -barb_d])
      cube([split_len + 0.1, split_w, 2 * barb_d]);
  }
}

// Hanger in use orientation: X = pivot axis (across the arm), Z = up, Y = along the arm.
// Pivot at the origin.
module hanger_use() {
  bar_top = -drop;
  difference() {
    union() {
      // two arms
      for (s = [-1, 1])
        translate([s * (inner / 2 + arm_t / 2) - arm_t / 2, -depth / 2, bar_top - bar_t])
          cube([arm_t, depth, drop + bar_t + top_above - depth / 2]);
      // rounded arm tops around the pivot
      for (s = [-1, 1])
        translate([s * (inner / 2 + arm_t / 2), 0, top_above - depth / 2])
          rotate([0, 90, 0]) cylinder(d = depth, h = arm_t, center = true);
      // bottom bar
      translate([-outer / 2, -depth / 2, bar_top - bar_t]) cube([outer, depth, bar_t]);
      // inner fillets between arms and bar
      for (s = [-1, 1])
        translate([s * (inner / 2 - 2), 0, bar_top + 2]) cube([4, depth, 4], center = true);
    }
    // screw hole into the magnet (vertical in use)
    translate([0, 0, bar_top - bar_t - 1]) cylinder(d = screw_d, h = bar_t + 2);
    // recess from the top so a short screw still reaches the magnet thread
    translate([0, 0, bar_top - bar_t + screw_floor]) cylinder(d = head_recess_d, h = bar_t);
  }
  // pegs pointing inward from each arm
  translate([-inner / 2, 0, 0]) peg_with_split();
  translate([inner / 2, 0, 0]) mirror([1, 0, 0]) peg_with_split();
}

// Print orientation: lay the hanger flat (its 10 mm thickness becomes the height).
module hanger_print() {
  translate([0, 0, depth / 2]) rotate([90, 0, 0]) hanger_use();
}

// A small coupon: one peg on a tab, to test the fit in a drilled hole first.
module peg_test() {
  translate([0, 0, depth / 2]) rotate([90, 0, 0]) {
    translate([-arm_t, -depth / 2, -8]) cube([arm_t, depth, 16]);
    peg_with_split();
  }
}

// ---- assembly preview with a ghost forearm end and magnet -------------------------
module assembly() {
  color("SteelBlue") hanger_use();
  // forearm end (ghost), pivot at origin
  %translate([-arm_width / 2, -pivot_back - 25, -pivot_up]) cube([arm_width, pivot_back + 25, 35]);
  color("silver") translate([0, 0, -drop - bar_t - mag_h]) cylinder(d = mag_d, h = mag_h);
}

if (part == "hanger") hanger_print();
else if (part == "peg_test") peg_test();
else if (part == "assembly") assembly();

echo(str("Pivot -> magnet face = ", drop + bar_t + mag_h, " mm  (use as TOOL_DOWN)"));
echo(str("Screw: ", screw_len, " mm long, ", screw_floor, " mm through plastic -> ", screw_len - screw_floor - 0.6, " mm into the magnet (with a 0.6 mm washer)"));
echo(str("Hanger outside width = ", outer, " mm, inside gap = ", inner, " mm"));
echo(str("Peg shaft = ", shaft_len, " mm, barb Ø", barb_d, " -> Ø", barb_tip_d));
