Kazxd/3dof-sorter/(list of files, cad)

Other CAD files:
cad/stl/magnet_hanger_petg_peg3.5.stl
