Kazxd/3dof-sorter/cad/preview/assembly.png

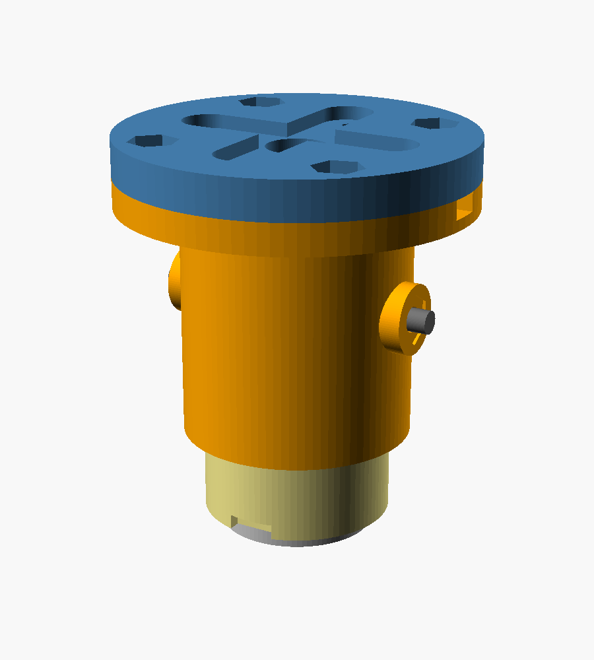
cad/preview/assembly.png
