Kazxd/3dof-sorter/cad/preview/hanger_assembly.png

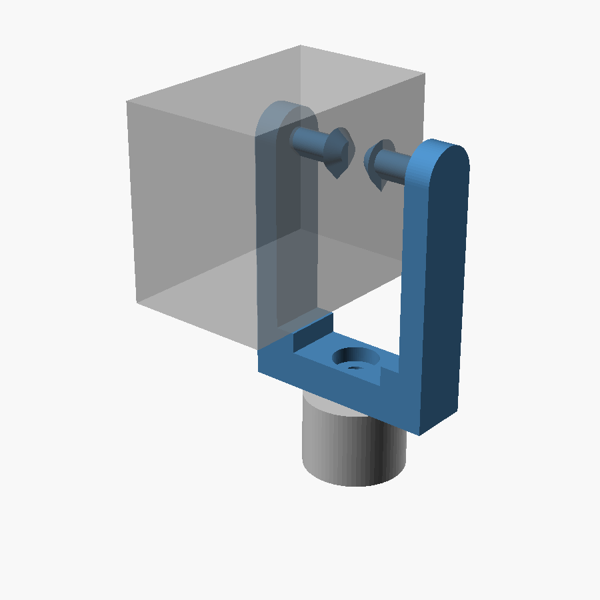
cad/preview/hanger_assembly.png
