Kazxd/3dof-sorter/Nuts and Bolts.v1i.yolov8/test/images/1_jpg.rf.10fcf405565f8a3b50d1d8b46127619a.jpg

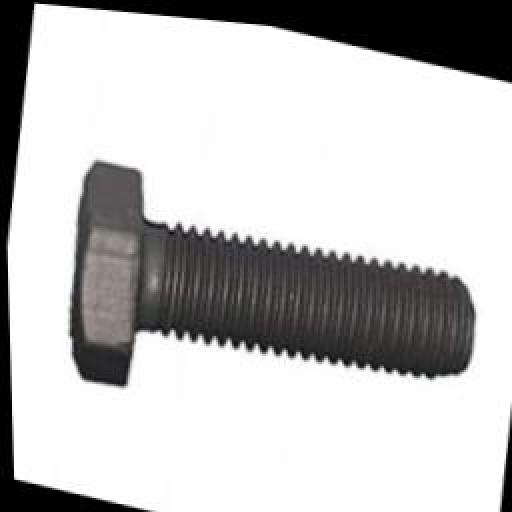
Nuts and Bolts.v1i.yolov8/test/images/1_jpg.rf.10fcf405565f8a3b50d1d8b46127619a.jpg
