Kazxd/3dof-sorter/Nuts and Bolts.v1i.yolov8/test/images/1_jpg.rf.693eba41cdc0d1709e851a7773b111f5.jpg

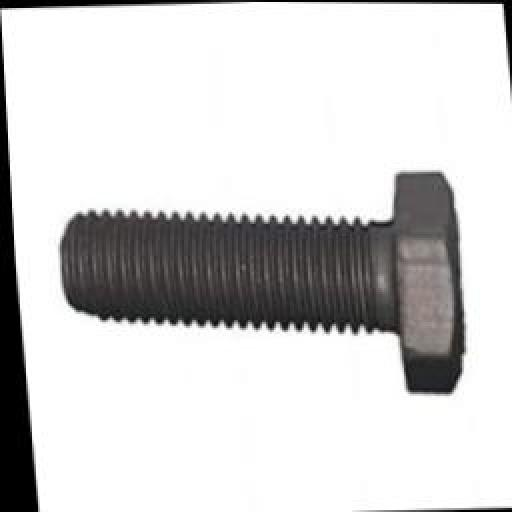
Nuts and Bolts.v1i.yolov8/test/images/1_jpg.rf.693eba41cdc0d1709e851a7773b111f5.jpg
