Kazxd/3dof-sorter/Nuts and Bolts.v1i.yolov8/test/images/20_jpg.rf.b9a9f57be443faaaa3e17ca910336969.jpg

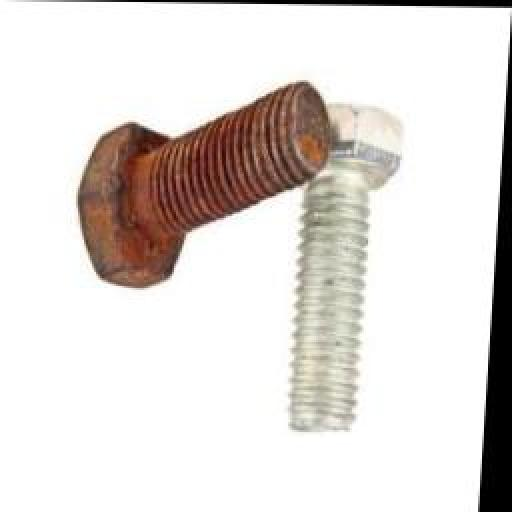
Nuts and Bolts.v1i.yolov8/test/images/20_jpg.rf.b9a9f57be443faaaa3e17ca910336969.jpg
