Kazxd/3dof-sorter/Nuts and Bolts.v1i.yolov8/test/images/28_jpg.rf.c78f9cbf81e81fbb7c6fdb72de72064d.jpg

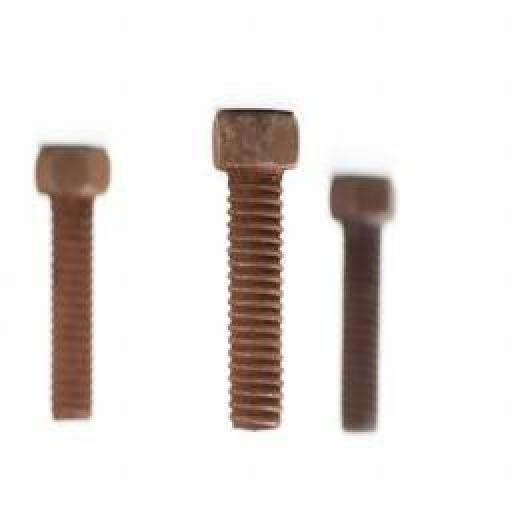
Nuts and Bolts.v1i.yolov8/test/images/28_jpg.rf.c78f9cbf81e81fbb7c6fdb72de72064d.jpg
