Kazxd/3dof-sorter/Nuts and Bolts.v1i.yolov8/test/images/51_jpg.rf.839dcff10445edbd0bcb69c974ce203c.jpg

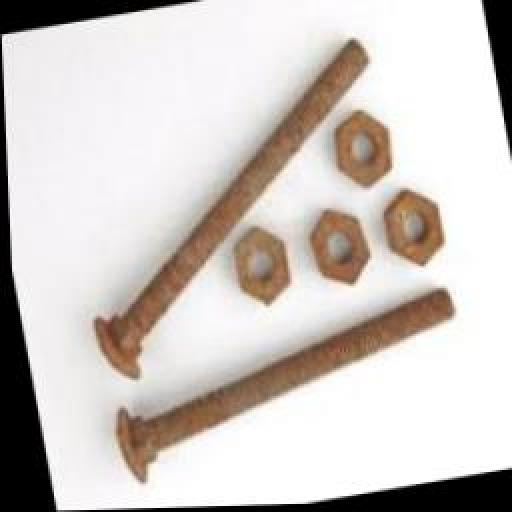
Nuts and Bolts.v1i.yolov8/test/images/51_jpg.rf.839dcff10445edbd0bcb69c974ce203c.jpg
