Kazxd/3dof-sorter/Nuts and Bolts.v1i.yolov8/test/images/360_F_80139244_RYSyfpNUsCVaAy7ESYCCBhgG2GHHbEat_jpg.rf.3d16d17b1271dd28471a1a89552681be.jpg

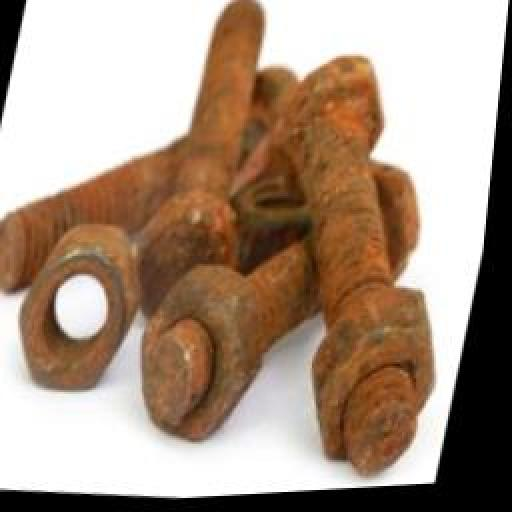
Nuts and Bolts.v1i.yolov8/test/images/360_F_80139244_RYSyfpNUsCVaAy7ESYCCBhgG2GHHbEat_jpg.rf.3d16d17b1271dd28471a1a89552681be.jpg
