Kazxd/3dof-sorter/Nuts and Bolts.v1i.yolov8/test/images/b64fee7129ad5ef68386fb461ede2bef_jpg.rf.705c23163af06195009a6687cba31095.jpg

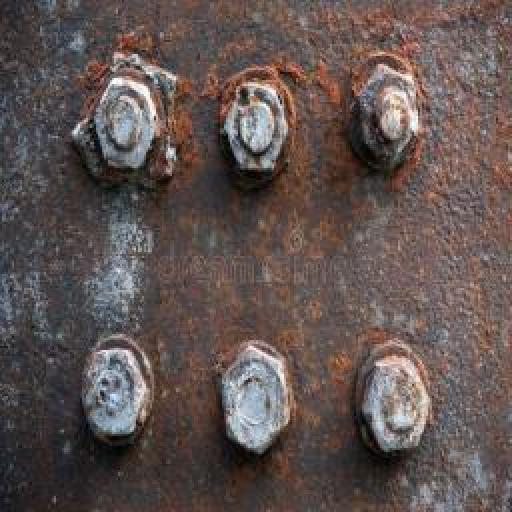
Nuts and Bolts.v1i.yolov8/test/images/b64fee7129ad5ef68386fb461ede2bef_jpg.rf.705c23163af06195009a6687cba31095.jpg
