Kazxd/3dof-sorter/Nuts and Bolts.v1i.yolov8/test/images/closeup-rusty-nut-bolts-isolated-260nw-499481761_jpg.rf.d3b3cb1ce00e6d4732e7971f7da68da3.jpg

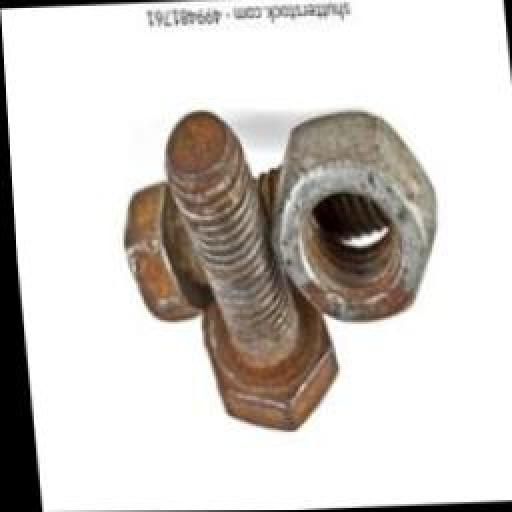
Nuts and Bolts.v1i.yolov8/test/images/closeup-rusty-nut-bolts-isolated-260nw-499481761_jpg.rf.d3b3cb1ce00e6d4732e7971f7da68da3.jpg
