Kazxd/3dof-sorter/Nuts and Bolts.v1i.yolov8/test/images/image_111_png_jpg.rf.cbd058981289f834f2aab9799236c0ad.jpg

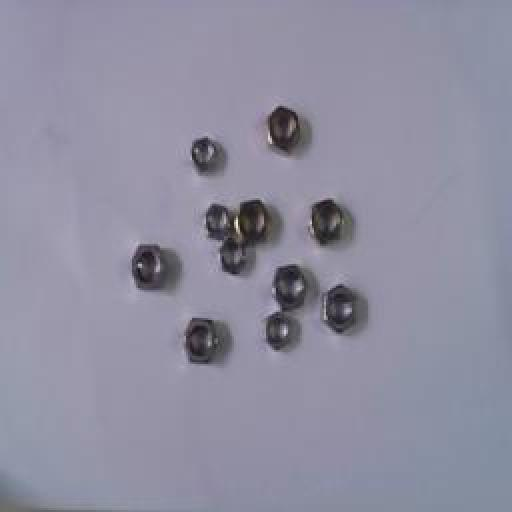
Nuts and Bolts.v1i.yolov8/test/images/image_111_png_jpg.rf.cbd058981289f834f2aab9799236c0ad.jpg
