Kazxd/3dof-sorter/Nuts and Bolts.v1i.yolov8/test/images/image_124_png_jpg.rf.042b700dd62eef889add78c70f98f33b.jpg

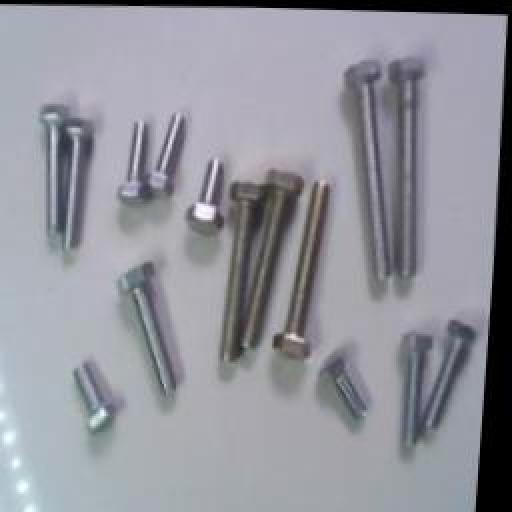
Nuts and Bolts.v1i.yolov8/test/images/image_124_png_jpg.rf.042b700dd62eef889add78c70f98f33b.jpg
