Kazxd/3dof-sorter/Nuts and Bolts.v1i.yolov8/test/images/image_155_png_jpg.rf.6860c4a50471471842574a31ea183f3c.jpg

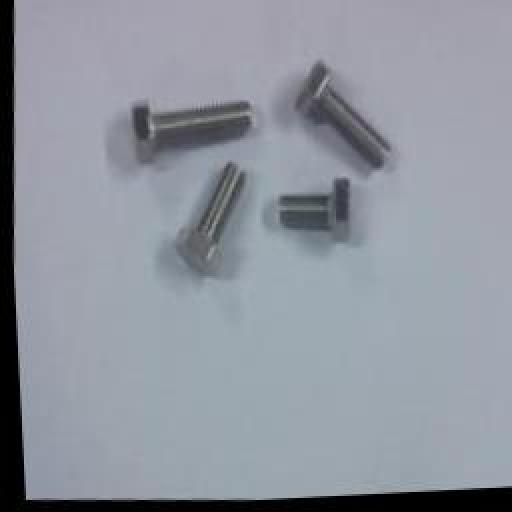
Nuts and Bolts.v1i.yolov8/test/images/image_155_png_jpg.rf.6860c4a50471471842574a31ea183f3c.jpg
