Kazxd/3dof-sorter/Nuts and Bolts.v1i.yolov8/test/images/image_159_png_jpg.rf.d07a37c939cdca8e4970845b6662ef78.jpg

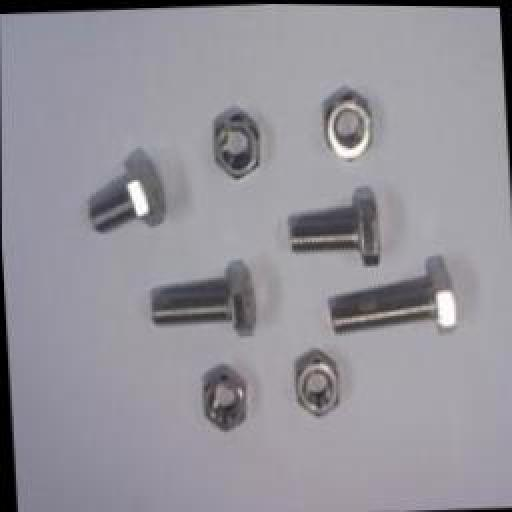
Nuts and Bolts.v1i.yolov8/test/images/image_159_png_jpg.rf.d07a37c939cdca8e4970845b6662ef78.jpg
