Kazxd/3dof-sorter/Nuts and Bolts.v1i.yolov8/test/images/images30_jpg.rf.4f71bb73b76494ddc299b52288be99b5.jpg

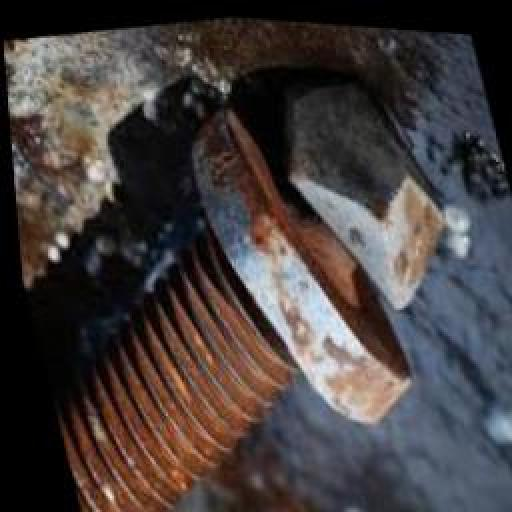
Nuts and Bolts.v1i.yolov8/test/images/images30_jpg.rf.4f71bb73b76494ddc299b52288be99b5.jpg
