Kazxd/3dof-sorter/Nuts and Bolts.v1i.yolov8/test/images/isometric-vector-illustration-steel-bolt-260nw-2467421423_jpg.rf.aa346c2119ab90e3ddb41b3eb776ee3a.jpg

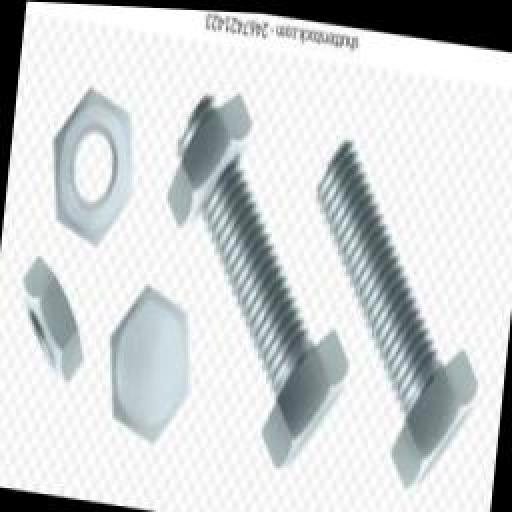
Nuts and Bolts.v1i.yolov8/test/images/isometric-vector-illustration-steel-bolt-260nw-2467421423_jpg.rf.aa346c2119ab90e3ddb41b3eb776ee3a.jpg
