Kazxd/3dof-sorter/Nuts and Bolts.v1i.yolov8/test/images/metal-nut-bolt-and-washer-084_jpg.rf.1c7996e1c7f5f97ce4830e85f09c6b82.jpg

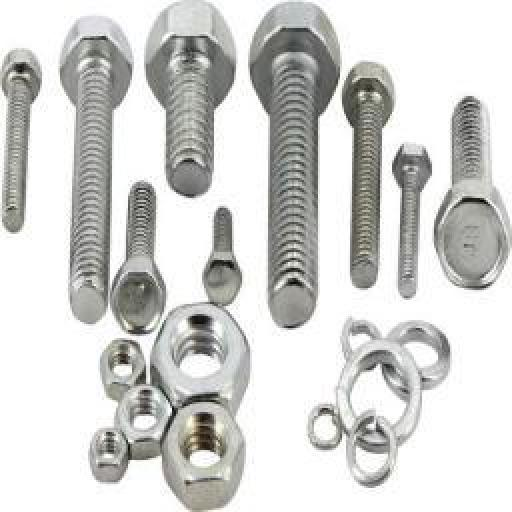
Nuts and Bolts.v1i.yolov8/test/images/metal-nut-bolt-and-washer-084_jpg.rf.1c7996e1c7f5f97ce4830e85f09c6b82.jpg
