Kazxd/3dof-sorter/Nuts and Bolts.v1i.yolov8/test/images/thumb-2-_jpg.rf.adc631dfd078fead626d603f33d43134.jpg

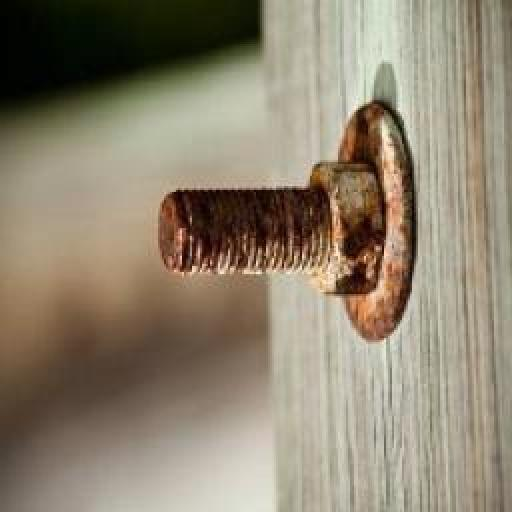
Nuts and Bolts.v1i.yolov8/test/images/thumb-2-_jpg.rf.adc631dfd078fead626d603f33d43134.jpg
