Kazxd/3dof-sorter/Nuts and Bolts.v1i.yolov8/test/images/thumb-16-_jpg.rf.5f6caaa617b7b7f0d733d57c1779624d.jpg

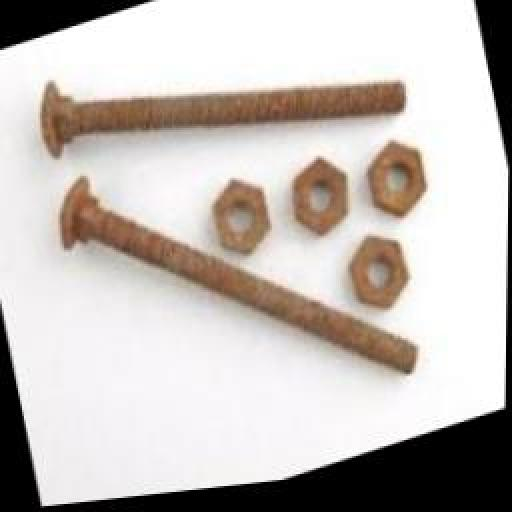
Nuts and Bolts.v1i.yolov8/test/images/thumb-16-_jpg.rf.5f6caaa617b7b7f0d733d57c1779624d.jpg
