Kazxd/3dof-sorter/Nuts and Bolts.v1i.yolov8/test/images/thumb-30-_jpg.rf.24ab0fd7bf11de27127de836d01d2cec.jpg

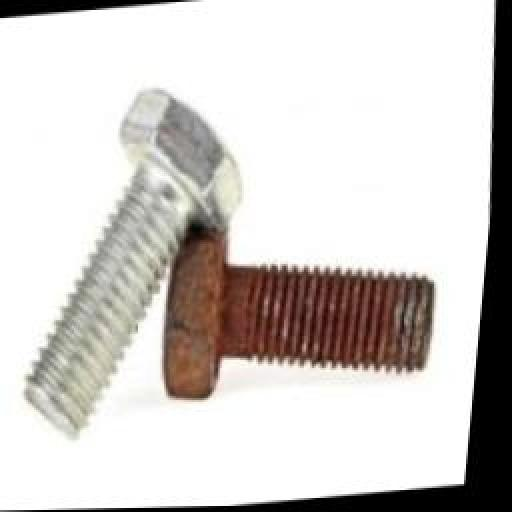
Nuts and Bolts.v1i.yolov8/test/images/thumb-30-_jpg.rf.24ab0fd7bf11de27127de836d01d2cec.jpg
