Kazxd/3dof-sorter/Nuts and Bolts.v1i.yolov8/test/images/thumb-38-_jpg.rf.464583c8fa75838264c796daad0b80d5.jpg

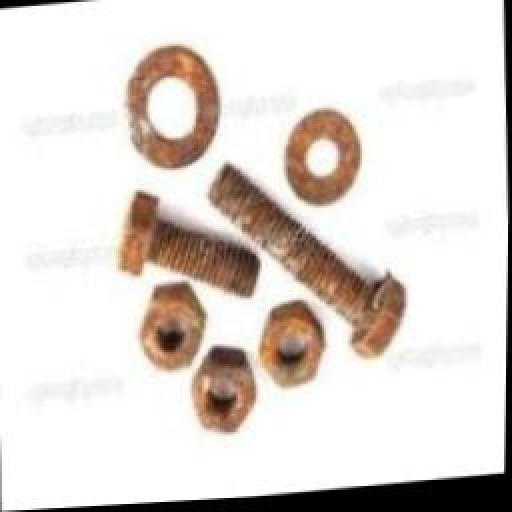
Nuts and Bolts.v1i.yolov8/test/images/thumb-38-_jpg.rf.464583c8fa75838264c796daad0b80d5.jpg
