Kazxd/3dof-sorter/Nuts and Bolts.v1i.yolov8/test/images/thumb-40-_jpg.rf.b5e35fa8e52e8ff97212c8392ecafc69.jpg

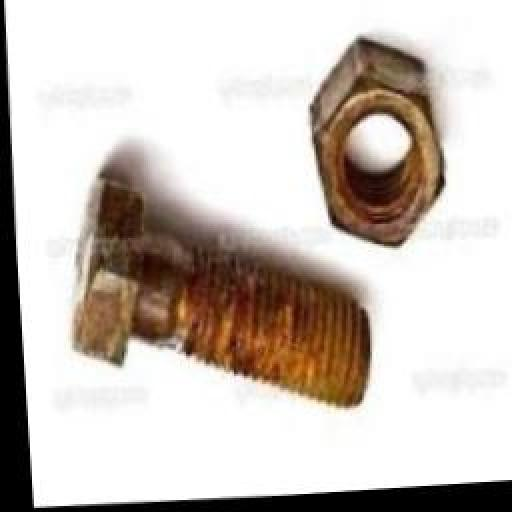
Nuts and Bolts.v1i.yolov8/test/images/thumb-40-_jpg.rf.b5e35fa8e52e8ff97212c8392ecafc69.jpg
