Kazxd/3dof-sorter/Nuts and Bolts.v1i.yolov8/test/images/thumb-43-_jpg.rf.7d5e36633b4abb25da9fab49657ad400.jpg

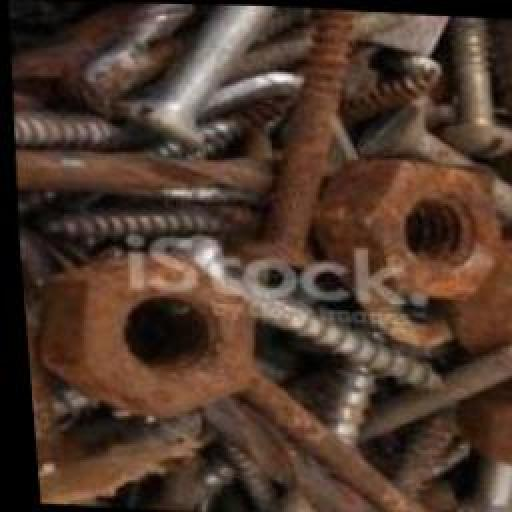
Nuts and Bolts.v1i.yolov8/test/images/thumb-43-_jpg.rf.7d5e36633b4abb25da9fab49657ad400.jpg
