Kazxd/3dof-sorter/Nuts and Bolts.v1i.yolov8/valid/images/pngtree-rusty-nut-and-bolt-repair-picture-image_13275147_png_jpg.rf.c70dbeb0f53fa2ed65e7a04f49e9ba68.jpg

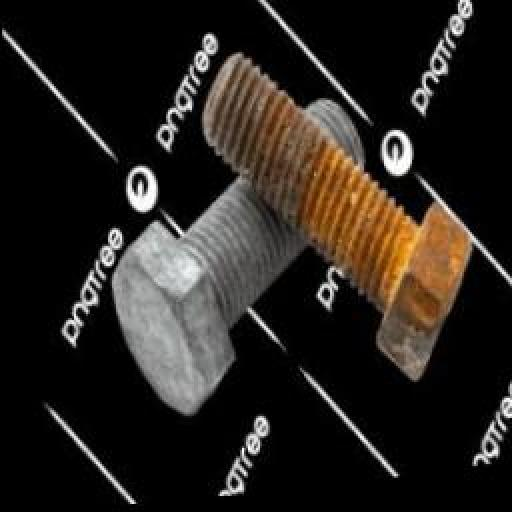
Nuts and Bolts.v1i.yolov8/valid/images/pngtree-rusty-nut-and-bolt-repair-picture-image_13275147_png_jpg.rf.c70dbeb0f53fa2ed65e7a04f49e9ba68.jpg
