Kazxd/3dof-sorter/(commit log)

2026-10-20 Add 5-DOF gripper sorter: vision, IK, serial protocol, firmware
    New sorter-5dof/ folder with the full pick-and-place stack for a
    5-DOF arm on a PCA9685 servo driver:
    - camera.py: background grabber that always serves the newest frame
    and reconnects on Wi-Fi drops
    - vision.py: YOLOv8 detection fused with an HSV + contour fallback;
    shape rules are measured in mm so a tilted phone does not skew them
    - mapping.py: pixel-to-mm homography (click or ArUco calibration)
    - kinematics.py: closed-form 5-DOF IK with tool-pitch search, joint
    limits and a table-collision floor
    - arm_link.py: serial protocol with sequence numbers, checksums,
    retries and ACK/DONE, plus a simulator
    - sorter.py: park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
2026-10-20 Switch end effector from gripper to a 12 V electromagnet
    - Replace the gripper with a KK-P20/15 electromagnet switched by a
    MOSFET on an Arduino pin (Nano D7 / ESP32 GPIO25). Firmware drives
    5 servos plus the magnet, turns the coil off if the PC goes silent
    for 5 s or it stays on for 30 s, and reports magnet state in POS.
    - Pick sequence: hover, press 3 mm past the part top, magnet on and
    settle, lift, carry, lower, magnet off and dwell, retreat. Wrist roll
    stays fixed because the magnet is round.
    - Add cad/: parametric OpenSCAD housing with a spring-loaded carrier
    (8 mm travel), servo-horn and bolt-pattern adapters, a rigid
    alternative, rendered STLs and an assembly/wiring gui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
2026-10-20 Add filament guidance for the magnet housing
2026-10-20 Support plate-mounted magnet head for arms without wrist roll
    - IK now models the magnet head as an offset from the wrist pitch axis
    (TOOL_FORWARD along the last link, TOOL_DOWN across it) with a
    selectable mount: "plate" (under the old gripper plate, magnet 90 deg
    to the last link) or "inline" (on a roll-servo horn).
    - adapter_bolt gets four radial slots so it fits any two holes 14-30 mm
    apart on the old gripper plate.
    - Placeholder elbow zero re-centred so the default workspace is
    reachable; test added for the inline mount.
2026-10-21 Add movement test tools
    - host/motion_test.py: staged test (link, home, each joint with a
    direction check, magnet, IK points, firmware speed cap, repeatability,
    park) with --sim, --stages and --amp; saves a report to runs/
    - firmware/servo_test: standalone Serial Monitor sketch for the first
    power-up, one servo at a time, outputs limp until commanded
    - ArmLink/SimArm.move return the board's real move duration
2026-10-21 Restore the 5-DOF solver on main; keep the 3-DOF patch on its own branch
    The 3-DOF adaptation (ab0d95e, c488894) now lives on the 3dof-adaptation
    branch. main goes back to the 5-DOF kinematics and config, keeping two
    real hardware facts from that patch: servos are wired to PCA9685
    channels 15-11, and the bench-tested 1000-2000 us pulse range.
2026-10-21 Restore ESP32 control and rigid-mount kinematics
2026-10-21 Make robot arm sorter setup reproducible
2026-10-26 Enforce magnet tilt limit on the pick pose
    The rigid-mount solver only checks TOOL_PITCH_TOLERANCE_DEG when the
    caller passes pitches; the sorter's contact pose did not, so it could
    press the magnet onto a part at 60-70 degrees. The contact pose now
    passes PITCH_CANDIDATES, so tilted picks are skipped as unreachable.
2026-10-26 Add free-swinging magnet hanger for the 3-joint arm
    U-shaped PETG hanger with snap-in barbed pegs that hook into two 6 mm
    holes drilled across the forearm end, so the electromagnet stays face
    down at any forearm angle. Includes a peg test coupon and fitting notes.
2026-10-26 Hanger pegs for an 8 mm forearm wall
    The measured wall is about 7 mm; the pegs are lengthened for 8 mm so the
    barb always clears into the hollow, leaving about 1 mm of side play.
2026-10-26 Hanger in TPU with thinner pegs and larger barbs
    Pegs go from 5.6 to 4.5 mm so they spin freely in the melted 6 mm holes,
    barbs grow to 8 mm and lose the split since TPU squeezes through, and the
    arms/bar are thickened to limit sway. Pivot to magnet face is now 62 mm.
2026-10-26 Recess the hanger's screw seat for a 10 mm screw
    The bottom bar stays 7 mm for stiffness, but a 9 mm recess around the
    screw leaves 4 mm of plastic under the head, so a 10 mm screw reaches
    about 5.4 mm into the magnet's thread.
2026-10-26 Add PLA/PETG hanger with short plain pegs
    style="rigid" exports a stiff-plastic hanger: 4.5 mm pegs that go 5 mm
    into the holes with no barbs, 3.5 mm arms so they bend safely for
    fitting, and the same recessed 4 mm screw seat.
2026-10-26 PETG hanger pegs down to 4.0 mm, plus a 3.5 mm copy
2026-10-26 Widen the hanger's arm gap to 30 mm
    1.5 mm clearance each side of the 27 mm forearm covers the measuring
    tolerance; pegs still reach 5 mm into the holes.
2026-10-26 Fix hanger peg print orientation; keep only the 4 mm version
    The peg teardrop now points to the bed in the print orientation, so the
    4 mm pegs print without a hanging round underside. Mesh checked: closed,
    37 x 52 x 10 mm, 30 mm between the arms, 4.0 mm pegs, 4.4 mm screw hole
    with a 9 mm head recess.
2026-10-26 Move the magnet MOSFET trigger to GPIO18
    GPIO25 sits on the ESP32 pin row that hangs off the breadboard. GPIO18
    is on the reachable row, is not a boot-strapping pin, and stays low at
    start-up.
2026-10-26 Wake servos one at a time at power-up
    All outputs start off, then base, elbow and shoulder are enabled 0.7 s
    apart. With the servo supply switched on before the ESP32 starts, the
    arm no longer jumps to its home pose with all joints at once.
2026-10-26 Use the full 500-2500 us servo range
    The 1000-2000 us bench range only gave about half of each servo's travel
    (a 70 degree command moved the shoulder ~45 degrees). The full range makes
    servo degrees match real degrees and lets each joint use its whole swing.
2026-10-27 servo_test: magnet on GPIO18 like arm_controller
2026-10-27 Hanging-magnet IK, elbow direction from the bench, reachable bins and pick area
2026-10-27 Calibration crosses around the demo pick area
2026-10-27 Measured arm: L1 from the turntable, L2 120, L3 75
2026-10-27 L1 = 95 mm, measured
2026-10-27 Bench calibration: elbow zero 123, elbow to 175, shoulder kept above level
2026-10-27 Bench tune: magnet face 10 mm lower, pick strip 177-185 mm
2026-10-27 Scripted demo: fixed nut and bolt spots, live camera window
2026-10-27 Camera URL for the demo phone
2026-10-27 Wait longer for the ESP32 at connect; tidy demo shutdown
2026-10-27 Magnet stays on until the PC turns it off; gentler pick; demo camera calibration by the arm, pick->drop arrows
2026-10-27 README: bench status, as-built wiring, hanging magnet, demo.py, open magnet issue
2026-10-27 README: bench procedure, driver wording; cad: L298N as built
